dinggefei/fridge-eink-display/docs/README.md

# 文档索引

当前实施基线为 V1.1：

- [正式用户使用说明书（Markdown）](USER_GUIDE.md)
- [PRD V1.1（Markdown）](PRD_V1.1.md)
- [GDEM075F53 480×800 竖屏预览](assets/screen_preview_f53_portrait.png)
- [GDEM075F53 800×480 原生传输图](assets/screen_preview_f53.png)
- [黄历模式 480×800 真实日期预览](assets/almanac_preview_f53_portrait.png)
- [黄历模式 800×480 原生传输图](assets/almanac_preview_f53.png)
- [黄历天气模式 480×800 布局预览](assets/almanac_weather_preview_f53_portrait.png)
- [黄历天气模式 800×480 原生传输图](assets/almanac_weather_preview_f53.png)
- [当前库存动态四色屏预览](assets/current_inventory_preview.png)

历史版本：

- [PRD V1.0（Markdown）](PRD_V1.0.md)

V1.1 已按实物硬件锁定 ESP32-S3 N16R8、GDEM075F53、JD79665CA 和
DESPI-C02。首次真机点屏仍须以 Good Display 的 F53 官方 ESP32 示例确认
初始化序列、像素顺序和四色编码，确认后再固化设备帧协议。
