dinggefei/fridge-eink-display/backend/THIRD_PARTY_NOTICES.md

# Third-party notices

## lunar-python 1.4.8

Project: https://github.com/6tail/lunar-python

MIT License

Copyright (c) 2020 6tail

Permission is hereby granted, free of charge, to any person obtaining a copy
of this software and associated documentation files (the "Software"), to deal
in the Software without restriction, including without limitation the rights
to use, copy, modify, merge, publish, distribute, sublicense, and/or sell
copies of the Software, and to permit persons to whom the Software is
furnished to do so, subject to the following conditions:

The above copyright notice and this permission notice shall be included in all
copies or substantial portions of the Software.

THE SOFTWARE IS PROVIDED "AS IS", WITHOUT WARRANTY OF ANY KIND, EXPRESS OR
IMPLIED, INCLUDING BUT NOT LIMITED TO THE WARRANTIES OF MERCHANTABILITY,
FITNESS FOR A PARTICULAR PURPOSE AND NONINFRINGEMENT. IN NO EVENT SHALL THE
AUTHORS OR COPYRIGHT HOLDERS BE LIABLE FOR ANY CLAIM, DAMAGES OR OTHER
LIABILITY, WHETHER IN AN ACTION OF CONTRACT, TORT OR OTHERWISE, ARISING FROM,
OUT OF OR IN CONNECTION WITH THE SOFTWARE OR THE USE OR OTHER DEALINGS IN THE
SOFTWARE.

## Market data services

Cryptocurrency quotes may be supplied by CoinGecko. Display attribution:
"Data provided by CoinGecko". API documentation and current terms:

- https://docs.coingecko.com/reference/simple-price
- https://www.coingecko.com/en/terms

Stock and index quotes may be supplied by Twelve Data. API documentation and
current terms:

- https://twelvedata.com/docs/introduction/overview
- https://twelvedata.com/terms

Stock and index quotes may also be supplied by the Longbridge OpenAPI Python
SDK, which is dual-licensed under Apache-2.0 and MIT. API documentation,
source code and current terms:

- https://open.longbridge.com/zh-CN/docs/quote/overview
- https://github.com/longbridge/openapi
- https://longbridge.com/terms

API access does not by itself grant every redistribution or public-display
right. The production operator must keep an appropriate plan and verify the
terms for each exchange and use case before enabling the market dashboard.

## Weather data service

Weather location and daily forecast data may be supplied by QWeather. The Mini
Program displays “天气服务由和风天气驱动” and the service website:

- https://www.qweather.com
- https://dev.qweather.com/docs/terms/attribution/

The e-ink screen intentionally omits a source footer. Before distributing the
physical device, the production operator must confirm that the selected plan
and any special-device attribution permission cover this presentation.
