dinggefei/fridge-eink-display/hardware/enclosure_v0_1/README.md

# 冰箱食物管理水墨屏外壳 V0.1

这是一套竖屏、磁吸冰箱门安装的原型外壳，适配当前已确认的 7.5 英寸水墨屏、ESP32-S3、DESPI-C02、806090 聚合物电池和 Seeed Studio Lipo Rider Plus。

V0.1 的目标是验证尺寸、装配、接口位置和磁吸强度，不是可直接销售的量产结构。当前成品外轮廓约为 **128 × 200 × 28.2 mm**。宽度从早期估算的 124 mm 增加到 128 mm，是为了在 112 mm 屏幕玻璃仓两侧保留可靠的螺丝柱和壳体强度。

## 必须先做的事情

不要直接打印完整外壳。先打印 `output/` 目录中的三个试配件：

1. `fit_test_screen_width_112mm.stl`：检查屏幕玻璃能否自然放入 112 mm 间距，不能夹紧或强塞。
2. `fit_test_battery_thickness_9mm.stl`：检查带保护板电池的实际厚度。槽高 9 mm；电池不得被挤压。
3. `fit_test_m2_insert_and_magnet.stl`：检查 M2 热熔螺母、M2 通孔和 10 × 3 mm 磁铁的实际公差。

只有三个试配件都通过，才打印三件主外壳。若任一试配件过紧或过松，先修改 `generate_enclosure.py` 参数并重新导出。

## 主打印文件

- `front_bezel_v0_1.stl`：正面边框、屏幕窗口和屏幕定位框。
- `middle_carrier_v0_1.stl`：屏幕背板以及电池、ESP32-S3、DESPI-C02、Lipo Rider Plus 的扎带固定孔。
- `rear_cover_v0_1.stl`：后盖、底部充电口和开关口、磁铁仓及后盖螺丝孔。

实物试摆已确认 V0.1 中层托板和后盖接口位置不正确。V0.1 现在只继续使用
`front_bezel_v0_1.stl`；中层托板和后盖改用
[`../enclosure_v0_3/README.md`](../enclosure_v0_3/README.md) 中的 V0.3 文件。

所有 STL 的单位均为 **毫米**，严禁自动缩放。

## 设计依据与待实物确认项

当前模型使用以下尺寸：

| 部件 | 模型采用尺寸 | 说明 |
| --- | --- | --- |
| GDEM075F53 | 111.2 × 170.2 × 1.2 mm | 屏幕仓 112 × 171 mm |
| ESP32-S3 开发板 | 27 × 65 mm 安装包络 | 用户实测板体约 25 × 63 × 8 mm，额外留装配余量 |
| DESPI-C02 | 42 × 24 mm 安装包络 | 裸板约 40 × 22 × 2 mm |
| 806090 电池 | 63 × 95 × 最大 10 mm 安装包络 | 下单电芯标称约 60 × 90 × 8 mm，必须以到货实测为准 |
| Lipo Rider Plus | 27 × 43 mm 安装包络 | 兼容约 25 × 41 mm 板体 |

以下尺寸目前仍需要装机验证：

- 电池保护板、导线出口和泡棉后的最大厚度。
- DESPI-C02 插入排线和杜邦线后的最大高度。
- Lipo Rider Plus 的 Type-C 插头和 USB-A 线缆弯折空间。
- 实物水墨屏的排线出口方向、窗口居中位置和玻璃批次公差。
- 冰箱门表面的磁吸效果；玻璃门或非磁性门不能依赖磁铁固定。

## 打印参数

建议第一版使用白色或浅灰色 PETG：

- 工艺：FDM。
- 喷嘴：0.4 mm。
- 层高：0.20 mm。
- 壁厚：4 道墙。
- 顶层/底层：各 5 层。
- 填充：20%～25% Gyroid。
- 尺寸补偿：关闭自动缩放；先用试配件验证商家的机器公差。

摆放方向：

- 正面边框：外观正面朝下打印；使用干净、平整的打印板。
- 中层托板：平整的屏幕接触面朝下打印。
- 后盖：贴冰箱的一面朝下打印。
- 支撑：默认不加全局支撑；若切片软件提示底部接口桥接风险，仅对接口位置增加局部支撑。

## 五金与辅料

- 10 × 3 mm 圆形强磁铁：6 个。建议购买 8 个，保留备件。
- M2 热熔铜螺母，外径约 3.2 mm、长度 4 mm：10 个。
- M2 × 6 mm 螺丝：6 个，用于中层托板固定到正面边框。
- M2 × 18 mm 螺丝：4 个，用于后盖；实际长度以试装为准，可同时准备 M2 × 16 和 M2 × 20。
- 0.5 mm EVA 泡棉胶：贴屏幕四周，不得覆盖显示区域或排线。
- 细魔术贴扎带或 2.5 mm 尼龙扎带：固定电池和各电路板。
- 薄毛毡或 TPU 防滑垫：贴后盖四角，防止刮伤冰箱门。
- 中性硅胶或适用于 PETG 的结构胶：磁铁试装确认后再粘接。

## 装配顺序

1. 仅拿空外壳安装热熔螺母。电池、屏幕和电路板必须远离烙铁，等待外壳完全冷却。
2. 将 0.5 mm EVA 贴在屏幕定位框四周，不能压住玻璃边缘和排线。
3. 屏幕自然放入正面边框，不得掰弯、挤压或用螺丝直接压玻璃。
4. 放上中层托板，用 6 颗 M2 × 6 mm 螺丝均匀、轻力锁紧。
5. 使用扎带固定电池和电路板；ESP32-S3 天线区域保持无遮挡，顶部区域不放磁铁和电池。
6. 检查 Type-C、开关、USB 线和排线均无受力，再通电做桌面测试。
7. 确认磁铁孔尺寸和极性后粘磁铁。所有磁铁朝冰箱的一面极性保持一致。
8. V0.3 托板必须搭配 V0.3 后盖，四颗后盖螺丝均可使用；如有翘曲立即停止并
   检查线缆和电池位置。

锂电池不得被螺丝、毛刺、扎带或壳体挤压。发现电池鼓包、破损、异常发热或异味时立即断电并停止使用。

## 重新生成与校验

在本目录运行：

```bash
python3 -m venv .venv-cad
source .venv-cad/bin/activate
python -m pip install -r requirements-cad.txt
python generate_enclosure.py
```

生成器会重新输出 STL、GLB、PNG 和 `output/manifest.json`。如果任一模型不是封闭实体或不是有效体积，脚本会直接报错而不会静默交付。
