dinggefei/fridge-eink-display/hardware/enclosure_v0_2/README.md

# 冰箱食材清单外壳：V0.2 中层托板

本目录只替换 **中层托板**。已经打印完成的以下 V0.1 零件继续使用，不需要重打：

- `front_bezel_v0_1.stl`
- `rear_cover_v0_1.stl`

## 为什么需要 V0.2

V0.1 的电子元件布局存在两个实际装配问题：

1. DESPI-C02 没有固定在屏幕 FPC 出口旁，FPC 无法自然直插。
2. Lipo Rider Plus 被按“USB-C 居中”处理，但官方 PCB 文件显示 USB-C 横向偏离板中心约 5.46 mm，导致原充电口难以对准。

V0.2 将元件改为：

- 左侧中部：806090 电池，竖放，两条魔术贴固定。
- 右上：ESP32-S3，竖放，天线朝上、USB-C 朝下。
- 右侧中部：DESPI-C02，横放，FPC 接口朝右并正对原 FPC 开槽。
- 左下：Lipo Rider Plus，按官方 4 个安装孔定位，USB-C 对准原后盖充电口。

## 与原后盖的兼容方式

原后盖保持不变。Lipo Rider Plus 的真实 PCB 位置与左下后盖螺柱冲突，因此：

- 右下、左上、右上共 3 颗后盖螺钉继续使用。
- 左下后盖螺钉不安装；托板上不再设置对应的热熔铜螺母柱。
- 原后盖左下螺钉孔可以装一颗不超过 5 mm 的短装饰螺钉，或者暂时空置；不要使用原来的长螺钉硬拧。

3 颗 M2 螺钉配合原后盖内部承托边，足以固定原型机后盖。

## 打印文件

- `output/middle_carrier_v0_2.stl`
- 打印店压缩包：`RFM_middle_carrier_v0_2_STL.zip`
- 布局图：`previews/middle_carrier_v0_2_layout.png`
- 三维预览：`previews/middle_carrier_v0_2.png`

## 建议打印参数

- 材料：PETG
- 喷嘴：0.4 mm
- 层高：0.20 mm
- 壁数：4
- 顶层/底层：5
- 填充：25%
- 支撑：关闭
- 摆放：大平面贴打印平台
- 数量：1 件

## 安装顺序

1. 先把屏幕和 DESPI-C02 接好，确认 FPC 完全插入并锁紧 ZIF 卡扣。
2. 用一条 6～8 mm 宽魔术贴将 DESPI-C02 固定在右侧中部，FPC 不得折死。
3. 用四颗 M2 × 4 mm 自攻螺钉固定 Lipo Rider Plus；USB-C 必须朝向托板底边。
4. 用两条 10～12 mm 宽魔术贴固定电池，电池与托板之间垫 0.5 mm EVA。
5. 固定 ESP32-S3；天线区域不要覆盖泡棉、导线或电池。
6. 接好短 SPI 线和短 USB-A 转 Type-C 供电线，再合上原后盖。
7. 后盖只安装 3 颗长 M2 螺钉：右下、左上、右上。左下长螺钉不要安装。

## 合盖前检查

- DESPI-C02 的 FPC 是直插状态，无明显拉力。
- Lipo Rider Plus 的 USB-C 能从原后盖充电孔正常插拔。
- 电池没有被托板、螺柱或后盖挤压。
- 所有板底焊点均有绝缘垫，导线不会碰到屏幕金属背板。
- 合盖后轻晃无明显异响，再进行通电测试。

> 原后盖底部原本预留的“开关孔”不能直接触达 Lipo Rider Plus 板载开关。V0.2 原型先将板载开关保持在 ON；该孔暂作预留，不在本次中层托板改版中扩展外置开关功能。
