dinggefei/fridge-eink-display/hardware/enclosure_v0_5/README.md

# 冰箱食材清单外壳 V0.5：装配公差与 ESP32 四孔固定版

> 2026-08-21 更新：ESP32-S3 不再使用扎带固定。中层托板改为利用开发板
> 四角的 4 个原生安装孔，以 4 颗 `M2×4 mm` 自攻螺丝固定。
>
> 2026-08-22 位置更新：ESP32 整板和四个安装孔向顶部充电口方向移动
> `25 mm`，后盖 BOOT/RESET 两个操作孔同步移动 `25 mm`。Lipo Rider 和
> 顶部充电口保持不动。
>
> 2026-08-22 后盖方向修正：后盖从外侧底视图观察时，BOOT/RESET 应位于
> 左侧。后盖孔位已沿 X 方向镜像，并在外表面增加 `BOOT`、`RESET` 两组
> `0.55 mm` 深凹刻标识。STL 和 1:1 SVG 均不需要再手工镜像。
>
> 2026-08-22 磁力增强：后盖磁铁由 6 颗增加为 10 颗，继续使用
> `Ø10×3 mm` 圆形磁铁。磁铁改为非对称安全布局，避开 ESP32 PCB
> 天线、ESP32 板体、DESPI-C02 与 Lipo Rider Plus。
>
> 2026-08-22 底边开孔更新：后盖底边原有的两个 `12×2 mm` 横向泄压孔
> 已取消并封闭为实心壁。顶部 USB-C 充电口保留。

> 2026-08-16 修正：最初生成的两个角部检具错误地截取了托板右上角和后盖右上角。
> 后盖合上时会左右镜像，正确组合应为“托板右上角 + 后盖左上角”。当前下载包
> 已修正；此前打印的同侧角检具作废。完整托板和完整后盖尺寸没有改变。

复核发现 V0.4 的中层托板为 `123 × 195 mm`，后盖内腔为
`123.8 × 195.8 mm`，每边只有 `0.4 mm` 间隙。对于接近 20 cm 的 FDM
打印件，该间隙容易被材料收缩、首层象脚和边缘毛刺吃掉，因此可能很难装入。

V0.5 调整为：

| 项目 | V0.4 | V0.5 |
|---|---:|---:|
| 中层托板 | 123 × 195 mm | 123 × 195 mm，保持不变 |
| 后盖内腔 | 123.8 × 195.8 mm | 124.6 × 196.6 mm |
| 每边装配间隙 | 0.4 mm | 0.8 mm |
| 后盖最小侧壁 | 2.1 mm | 1.7 mm |
| 托板与承托台阶搭接 | 1.6 mm | 1.2 mm |
| 后盖外轮廓 | 128 × 200 mm | 128 × 200 mm，保持不变 |

`1.7 mm` 侧壁适合 0.4 mm 喷嘴打印约 4 道墙；`1.2 mm` 台阶搭接仍能承托
托板。顶部充电口和 Lipo Rider 位置不变；ESP32 及对应的 BOOT/RESET 后盖孔
按上述要求同步上移 `25 mm`。

## ESP32 四孔固定参数

开发板外形参考[微雪 ESP32-S3-DEV-KIT-NXRX 官方尺寸图](https://docs.waveshare.com/ESP32-S3-DEV-KIT-N8R8)，
四孔孔距采用用户在 `2026-08-22` 对实际 `ESP32-S3-DEV-KIT-N16R8` 板卡的测量值：

| 项目 | 数值 |
|---|---:|
| 开发板外形 | 63.30 × 25.40 mm |
| 原生安装孔 | 4 × Ø2.00 mm |
| 左右孔距 | 22.00 mm，实测 |
| 上下孔距 | 60.00 mm，实测 |
| 中托螺丝柱外径 | 5.80 mm |
| 自攻底孔 | Ø1.70 × 2.50 mm 深，盲孔 |
| 固定螺钉 | 4 × M2×4 mm 自攻螺丝 |
| PCB 标称厚度 | 1.60 mm |
| 标称啮合长度 | 2.40 mm |

使用要求：

1. 四角 4 个原生孔必须全部固定，不能只装两颗螺丝。
2. 螺钉头外径应不大于 `3.6 mm`；下方靠近 USB-C 的两颗螺钉禁止加垫圈，
   避免遮挡 BOOT/RESET 按钮。
3. 仅拧到开发板不晃动即可，不要继续强拧到底，以免中托螺丝柱开裂。
4. 不要把 `M2×6 mm` 直接替代 `M2×4 mm`，因为盲孔深度按 M2×4 设计。
5. 从后盖操作 BOOT/RESET 时使用直径不大于 `1.5 mm` 的非金属细杆。
6. `esp32_four_hole_alignment_v0_5.png` 展示四颗螺丝与 BOOT/RESET 后盖孔的
   同时对位关系；`placement_template_v0_5_1to1.svg` 可按 100% 打印复核孔位。

更新后的载板坐标以中托中心为 `(0, 0)`：

- ESP32 中心：`(-35.00, 45.00)`。
- 下方两个安装孔：`(-46.00, 15.00)`、`(-24.00, 15.00)`。
- 上方两个安装孔：`(-46.00, 75.00)`、`(-24.00, 75.00)`。
- 开发板元件面 BOOT 中心：`(-43.146, 15.905)`。
- 开发板元件面 RESET 中心：`(-27.758, 15.678)`。
- 后盖模型 BOOT 孔中心：`(43.146, 15.905)`；从后盖外侧底视图看位于左侧。
- 后盖模型 RESET 孔中心：`(27.758, 15.678)`；从后盖外侧底视图看位于左侧。

后盖安装时会左右翻转，因此开发板按钮和后盖模型孔的 X 坐标符号相反，这是
正确的装配关系。不要在切片软件中再次镜像后盖。

后盖底边不再保留泄压孔或走线孔；底边应是完整连续的实心外壁。

## 后盖磁铁参数

| 项目 | 数值 |
|---|---:|
| 磁铁数量 | 10 颗 |
| 磁铁规格 | Ø10×3 mm |
| 盲孔尺寸 | Ø10.4×3.2 mm |
| 冰箱门一侧保留PETG厚度 | 0.8 mm |
| 装配后投影坐标 | 见下方列表 |

磁铁中心坐标以中托上的电子器件视图为准，顶部 USB-C 方向为
`Y+`：

```text
(-52, -70)   (0, -70)   (52, -70)
(-52, -40)   (0, -40)   (52, -40)
(-52, -10)
(0, 30)
(52, 35)     (52, 70)
```

后盖合上时会左右翻转，因此 STL 内部盲孔的 X 坐标与上述装配投影
坐标符号相反。这个镜像已经由生成程序处理，不要在切片软件中再次镜像。

保守的平面投影净距为：ESP32 PCB 天线 `33.52 mm`、ESP32 板体
`17.10 mm`、DESPI-C02 `17.16 mm`、Lipo Rider Plus `20.05 mm`。
`magnet_electronics_clearance_v0_5.png` 展示装配后的磁铁与电子器件相对位置。

磁铁从后盖内侧装入盲孔。先逐孔试放，确认能自然放入且不晃动，再使用少量适合
PETG的结构胶固定。胶水固化前不得合盖；不得敲击、强压磁铁，也不要通过减薄
外侧 `0.8 mm` 表皮来增加吸力。

## 必须先打印 ESP32 四孔检具

在打印完整中层托板前，先打印：

`fit_test_esp32_four_hole_mount_v0_5.stl`

检具验收顺序：

1. 检具底边缺口朝向开发板 USB-C 端。
2. 将真实 ESP32 的 4 个原生孔自然落到 4 个螺丝柱中心；不得弯板或斜压。
3. 先徒手放入 4 颗 M2×4，自然旋入 1～2 圈，确认四孔可同时对中。
4. 按对角顺序逐步拧紧，开发板应平放，四角不能翘起。
5. 用细塑料杆分别按压 BOOT 和 RESET，螺钉头不得妨碍按键。
6. 四孔全部对齐、板面平整、可正常按键，才允许打印完整
   `middle_carrier_v0_5.stl`。

任何一个孔需要扩孔、掰板或强行拉到螺丝柱上，都判定为失败；不要继续打印完整件。

## 当前安装位置图

器件位置以 `enclosure_v0_5_four_hole_layout.png` 为准：

1. Lipo Rider Plus 位于顶部中央，USB-C 充电口朝向后盖顶部开孔。
2. ESP32-S3 位于左侧，天线朝上，BOOT、RESET 和 Type-C 朝下；四角使用
   M2×4 自攻螺丝固定，不使用扎带。
3. DESPI-C02 位于右侧中部，白色 FPC 插座朝右并直连屏幕排线。
4. 806090 电池横放在下半部电池槽内。

当前精确图分为：

- `enclosure_v0_5_four_hole_layout.png`：上移 25 mm 后的完整器件位置。
- `esp32_four_hole_alignment_v0_5.png`：四颗螺丝、BOOT/RESET 和后盖孔的相对位置。
- `carrier_rear_clearance_v0_5.png`：中托与后盖的装配间隙。
- `rear_cover_bottom_view_v0_5.png`：从后盖外表面观察的最终孔位和文字方向。

此前的写实效果图仍是 ESP32 上移前的位置，已从正式打印包中移除。打印尺寸以
STL、`manifest.json` 和 1:1 SVG 模板为准。实际供电顺序为“电池 → Lipo Rider
电池接口 → Lipo Rider USB-A 输出 → ESP32-S3 USB-C”。

## 必须先打印角部试配件

不要先打印完整托板和后盖。先打印以下两个小件：

1. `fit_test_carrier_corner_v0_5.stl`
2. `fit_test_rear_corner_v0_5.stl`

两个试配件必须使用与正式件相同的材料、打印机、喷嘴、层高和缩放设置。

验收方法：

1. 去掉裙边、拉丝和明显毛刺，但不要打磨配合边。
2. 将托板角部试件按螺丝柱方向放入后盖角部试件。
3. 后盖角件空腔朝上；托板角件左右翻面、元件柱朝下后再合入。
4. 圆角与螺丝孔应同时重合；应能用手自然放入和取出，不需要掰后盖，
   也不能靠螺钉拉进去。
5. 轻晃时允许很小的活动量，但不能明显横向晃动或脱出台阶。
6. 试件通过后，才打印 `middle_carrier_v0_5.stl` 和 `rear_cover_v0_5.stl`。

这里的角部试件只验证“中托能否装入后盖”；ESP32 四孔检具另行验证真实开发板
孔距。两类检具都通过后，才打印完整中托。

如果试件仍紧，先确认切片软件没有自动缩放、首层没有明显象脚，再调整模型；
不要直接打印完整件碰运气。

## 打印设置

- PETG，0.4 mm 喷嘴，0.20 mm 层高。
- 4 道墙，顶层/底层各 5 层，25% Gyroid。
- STL 单位为毫米，自动缩放关闭。
- 建议开启切片软件的象脚补偿 `0.15～0.20 mm`；不同软件名称可能是
  `Elephant Foot Compensation` 或“首层水平扩展补偿”。

## 重新生成

```bash
../enclosure_v0_1/.venv-cad/bin/python generate_enclosure_v0_5.py
```

所有 STL 导出后都会重新加载，验证水密、有效体积和单一实体。
