dinggefei/fridge-eink-display/docs/assets/almanac_weather_preview_f53.png

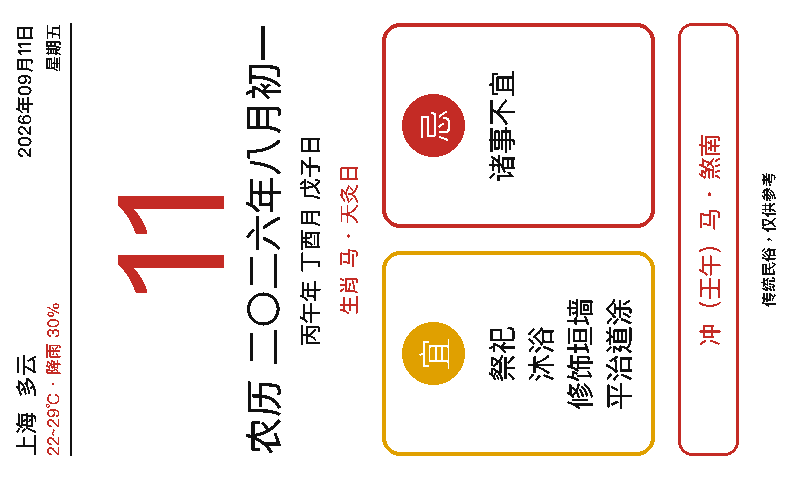
docs/assets/almanac_weather_preview_f53.png
