dinggefei/fridge-eink-display/docs/assets/market_preview_f53.png

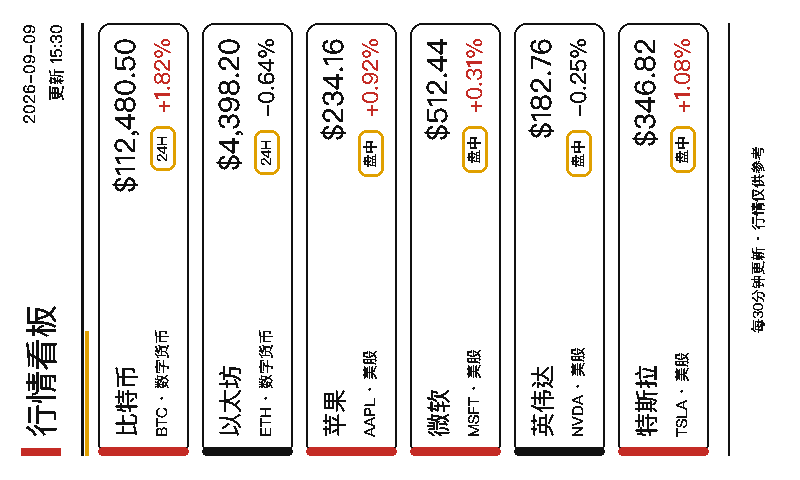
docs/assets/market_preview_f53.png
