dinggefei/fridge-eink-display/docs/assets/screen_preview_f53.png

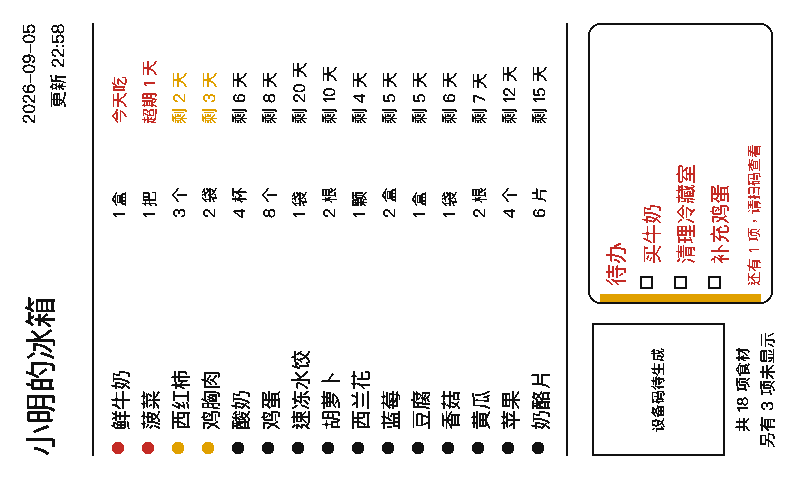
docs/assets/screen_preview_f53.png
