dinggefei/fridge-eink-display/docs/assets/timetable_mode/three_day_timetable_20260917_portrait.png

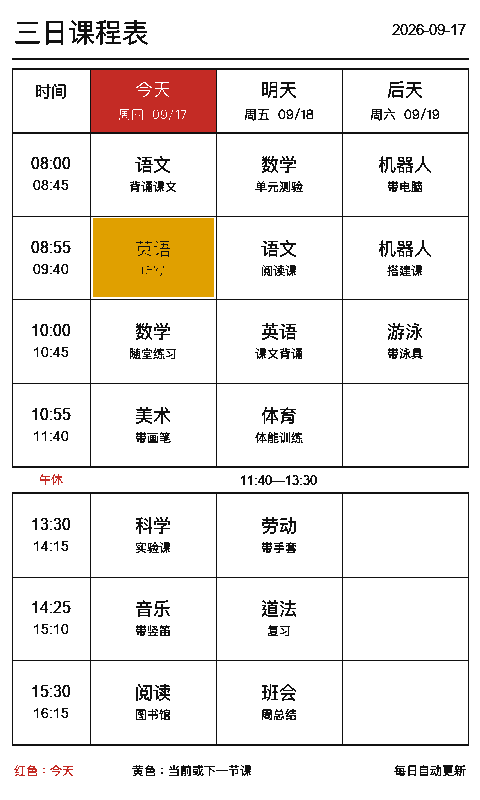
docs/assets/timetable_mode/three_day_timetable_20260917_portrait.png
