dinggefei/fridge-eink-display/docs/assets/timetable_mode/three_day_timetable_implemented_20260917_native.png

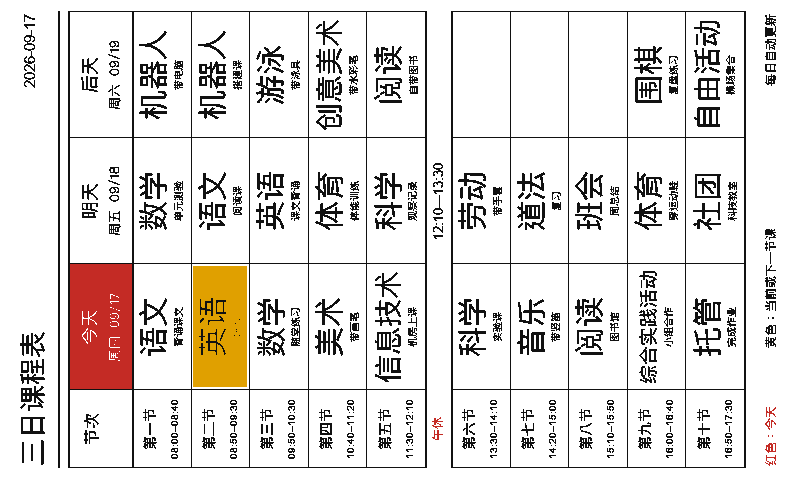
docs/assets/timetable_mode/three_day_timetable_implemented_20260917_native.png
