dinggefei/fridge-eink-display/docs/assets/timetable_mode/weekly_timetable_20260916_native.png

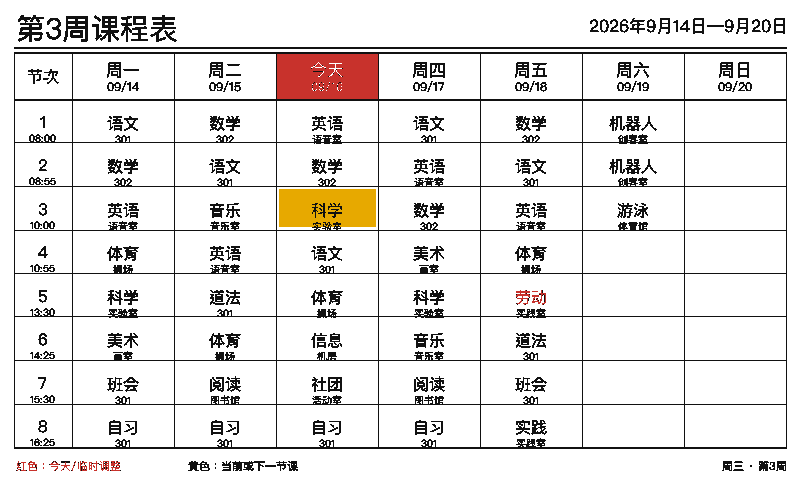
docs/assets/timetable_mode/weekly_timetable_20260916_native.png
