dinggefei/fridge-eink-display/docs/assets/timetable_mode/weekly_timetable_adaptive_font_20260919_preview.png

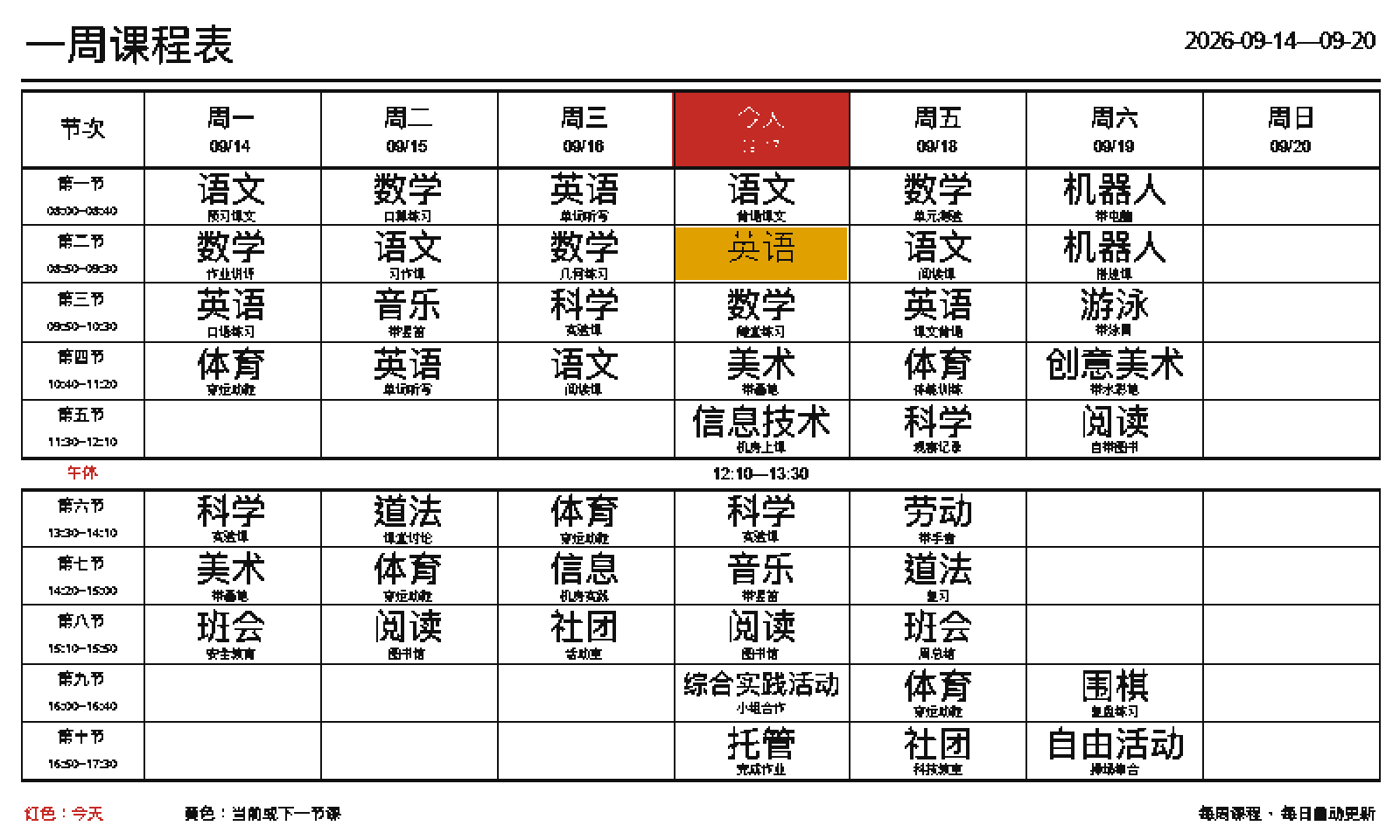
docs/assets/timetable_mode/weekly_timetable_adaptive_font_20260919_preview.png
