dinggefei/fridge-eink-display/docs/assets/timetable_mode/weekly_timetable_custom_periods_20260916_native.png

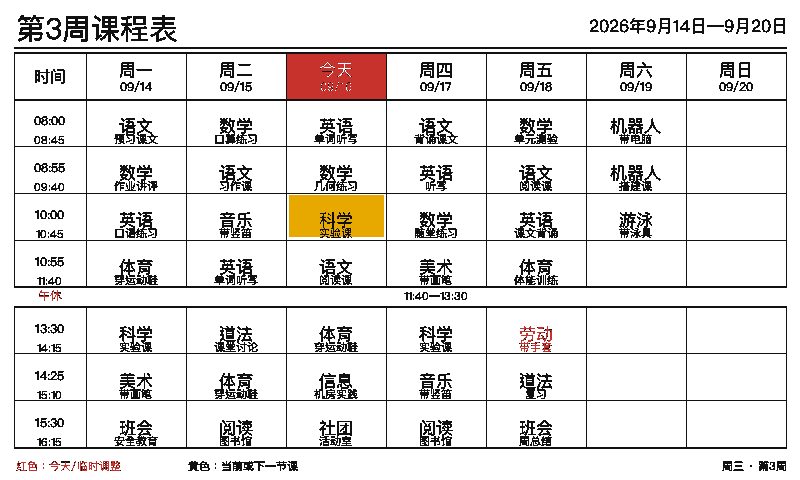
docs/assets/timetable_mode/weekly_timetable_custom_periods_20260916_native.png
