dinggefei/fridge-eink-display/docs/assets/timetable_mode/weekly_timetable_custom_periods_20260916_preview.png

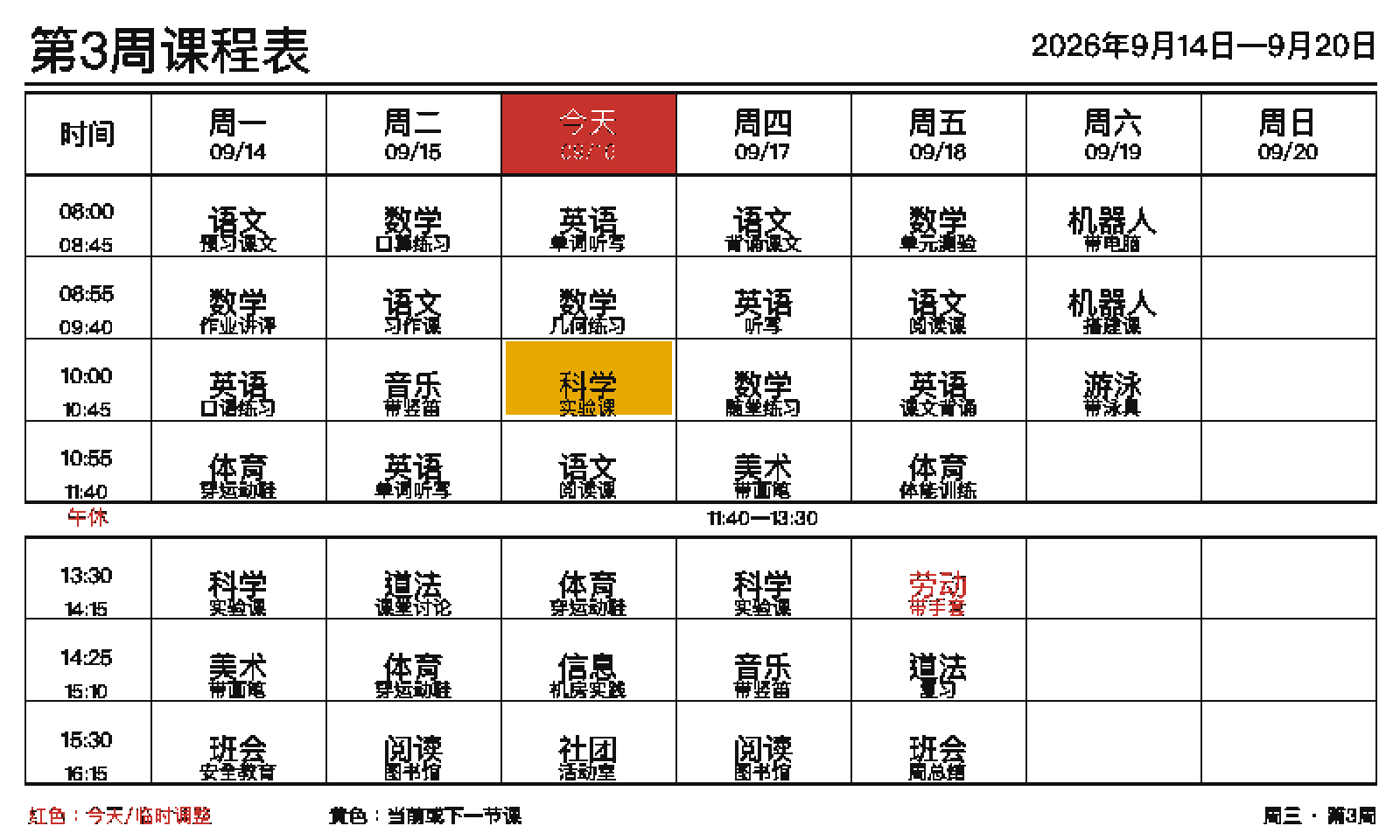
docs/assets/timetable_mode/weekly_timetable_custom_periods_20260916_preview.png
