dinggefei/fridge-eink-display/docs/assets/timetable_mode/weekly_timetable_implemented_20260916_preview.png

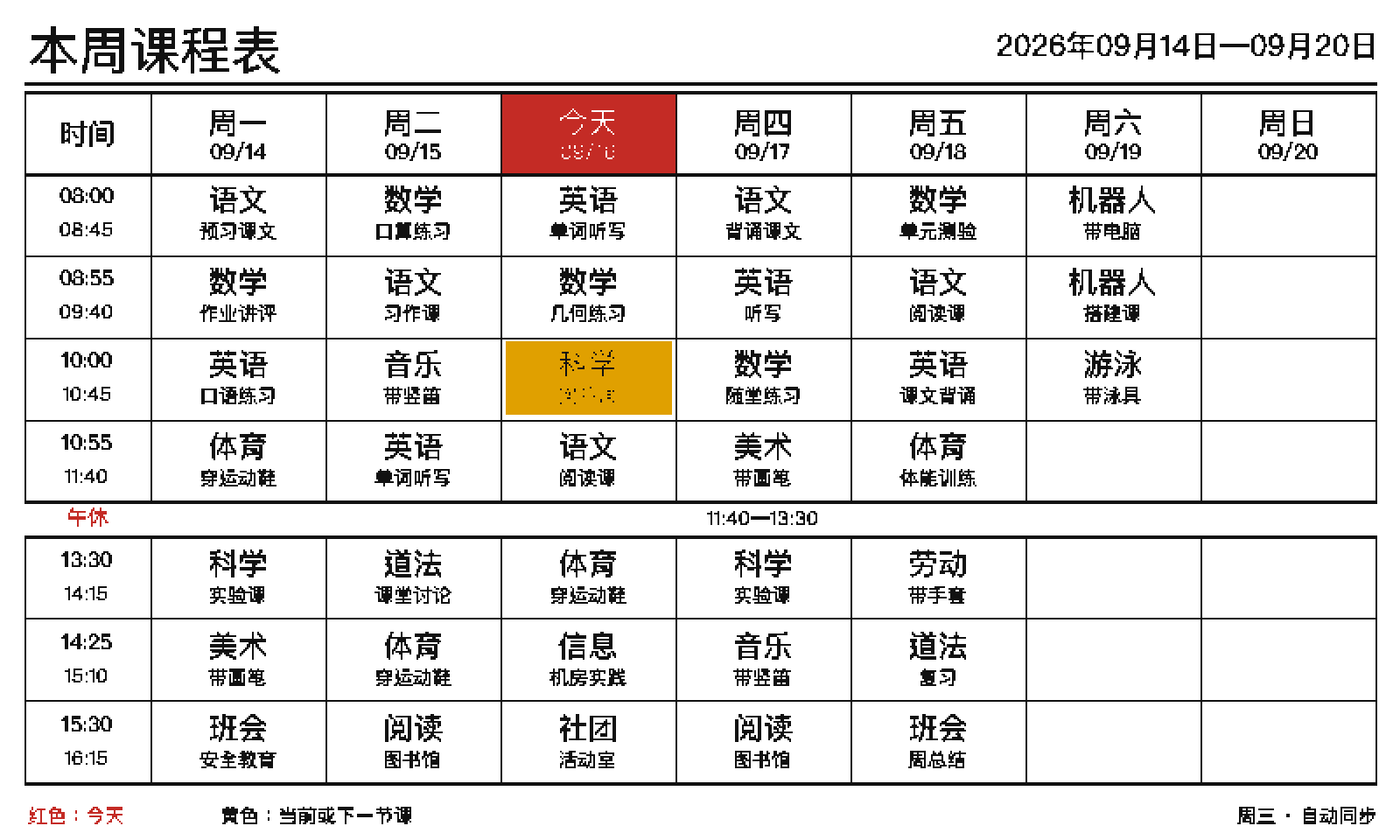
docs/assets/timetable_mode/weekly_timetable_implemented_20260916_preview.png
