dinggefei/fridge-eink-display/docs/assets/weather_mode/weather_7day_20260915_native.png

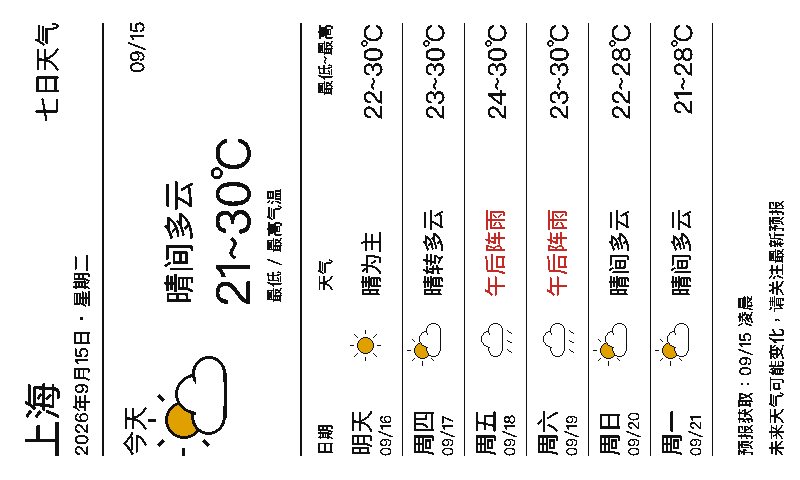
docs/assets/weather_mode/weather_7day_20260915_native.png
