dinggefei/fridge-eink-display/hardware/enclosure_v0_7/previews/compact_enclosure_overview_v0_7.png

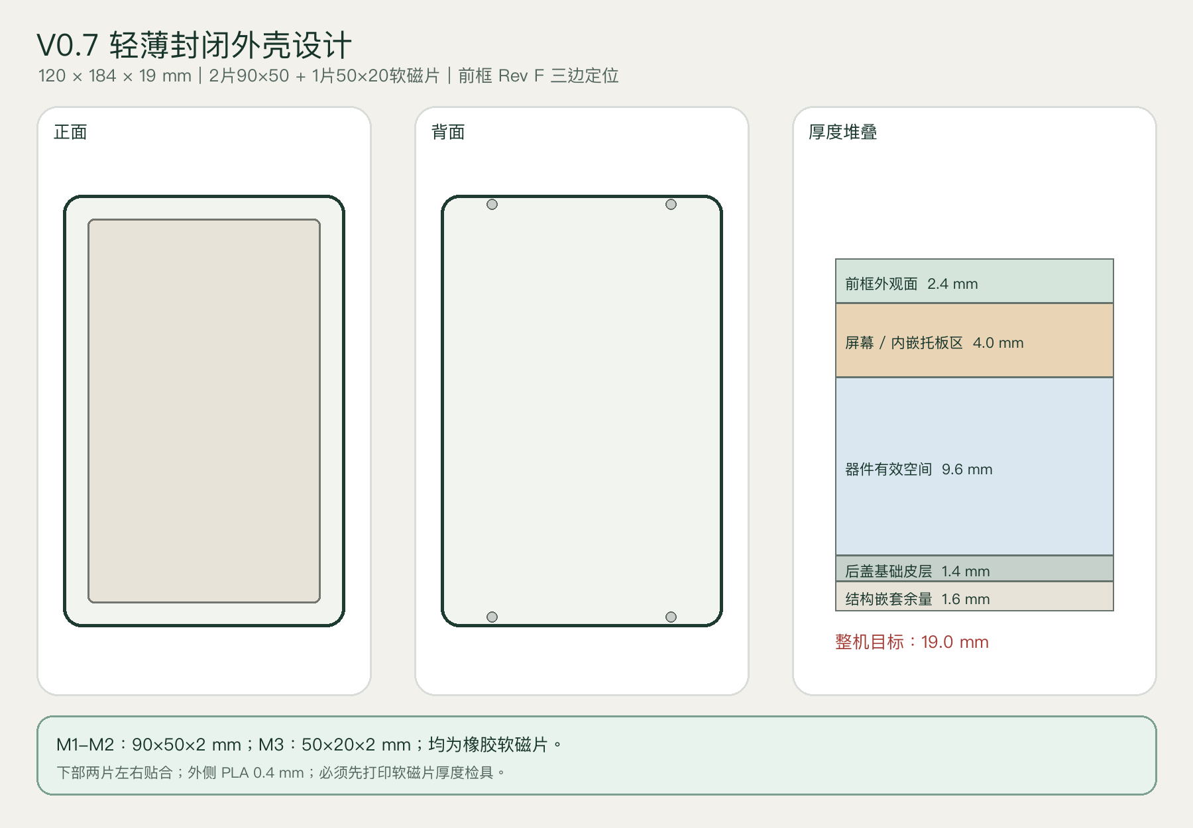
hardware/enclosure_v0_7/previews/compact_enclosure_overview_v0_7.png
