dinggefei/fridge-eink-display/hardware/enclosure_v0_7/previews/esp32_dupont_terminal_clamp_v0_7_rev_a.png

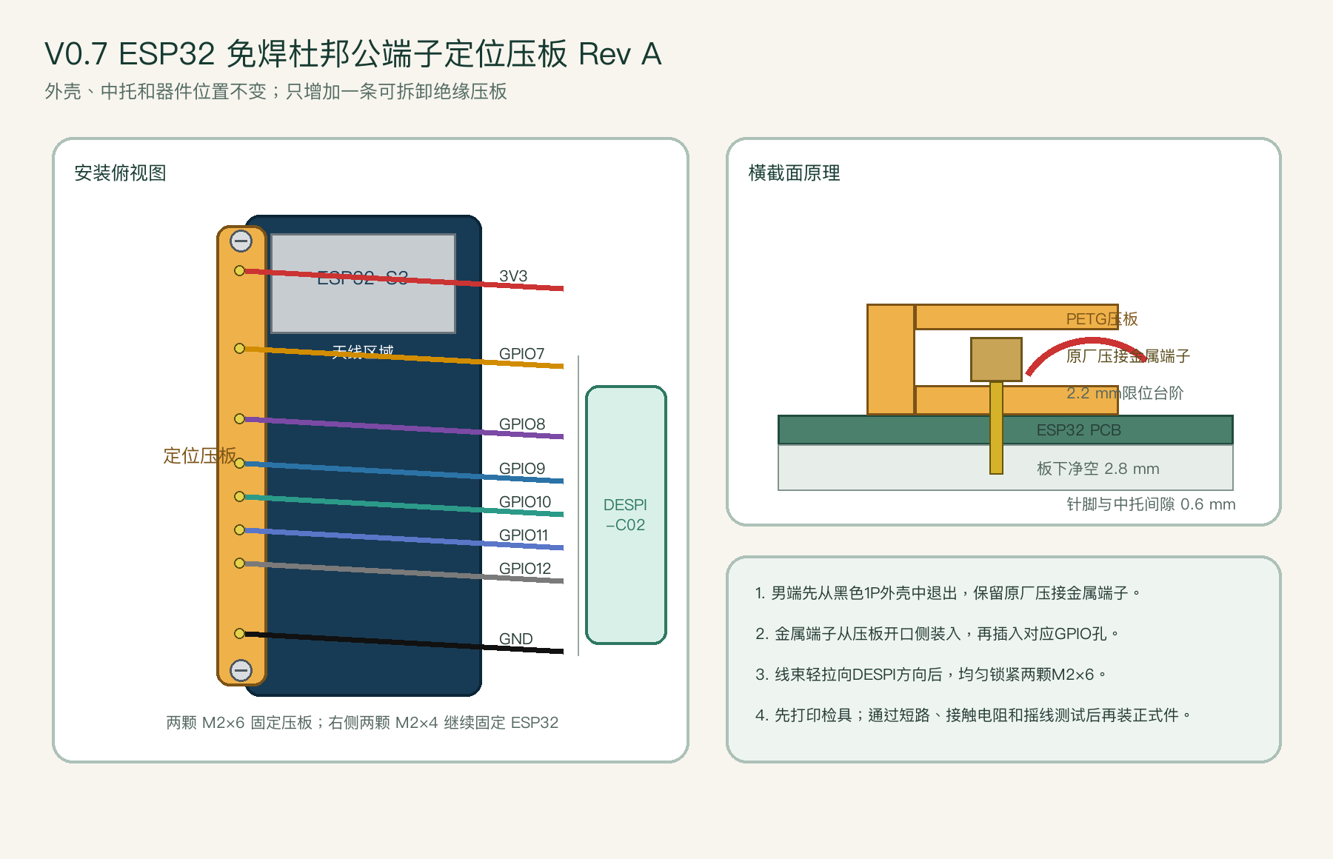
hardware/enclosure_v0_7/previews/esp32_dupont_terminal_clamp_v0_7_rev_a.png
