dinggefei/fridge-eink-display/hardware/enclosure_v0_7/previews/front_retainer_revision_v0_7_rev_f.png

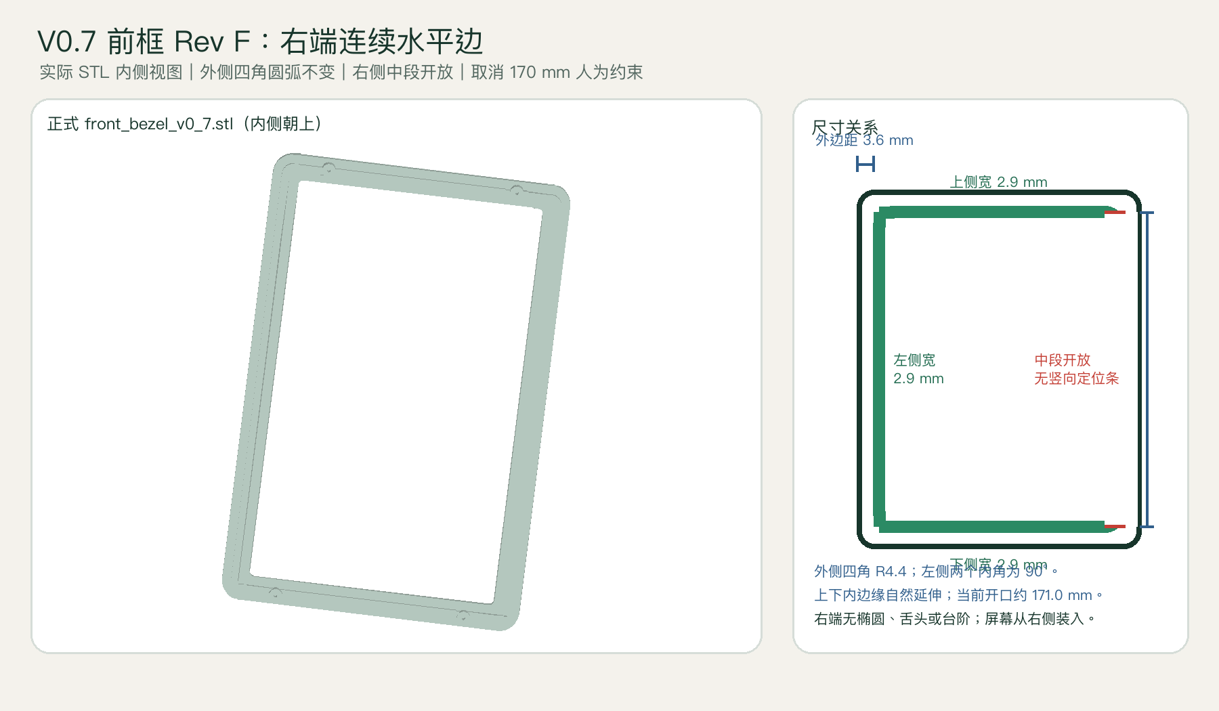
hardware/enclosure_v0_7/previews/front_retainer_revision_v0_7_rev_f.png
