dinggefei/fridge-eink-display/hardware/enclosure_v0_7/previews/lipo_regular_opening_proposal_v0_7.png

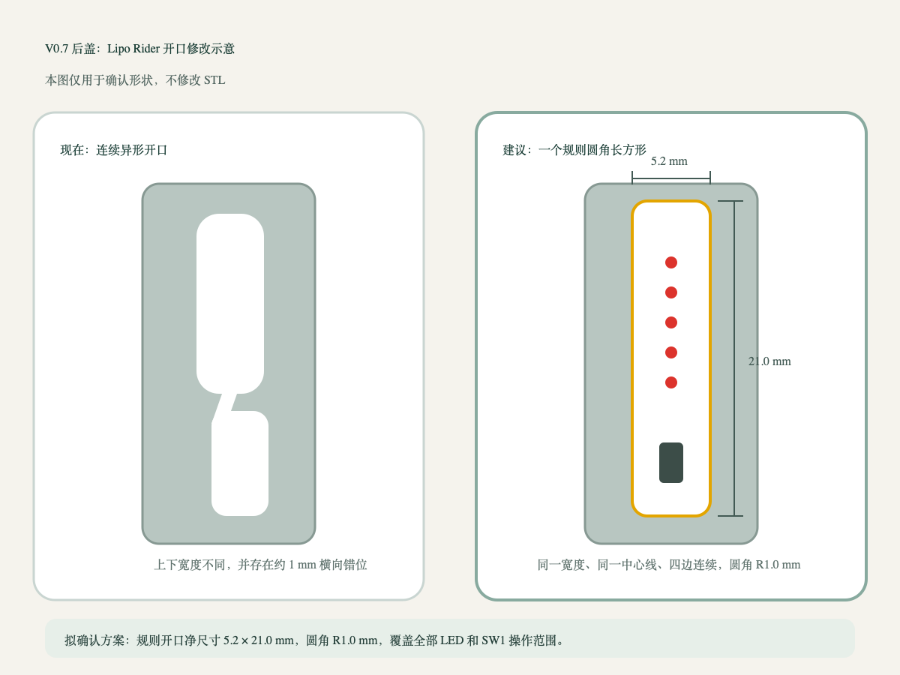
hardware/enclosure_v0_7/previews/lipo_regular_opening_proposal_v0_7.png
