dinggefei/fridge-eink-display/hardware/enclosure_v0_7/previews/magnet_layout_1x90x50_2x50x20_proposal_v0_7.png

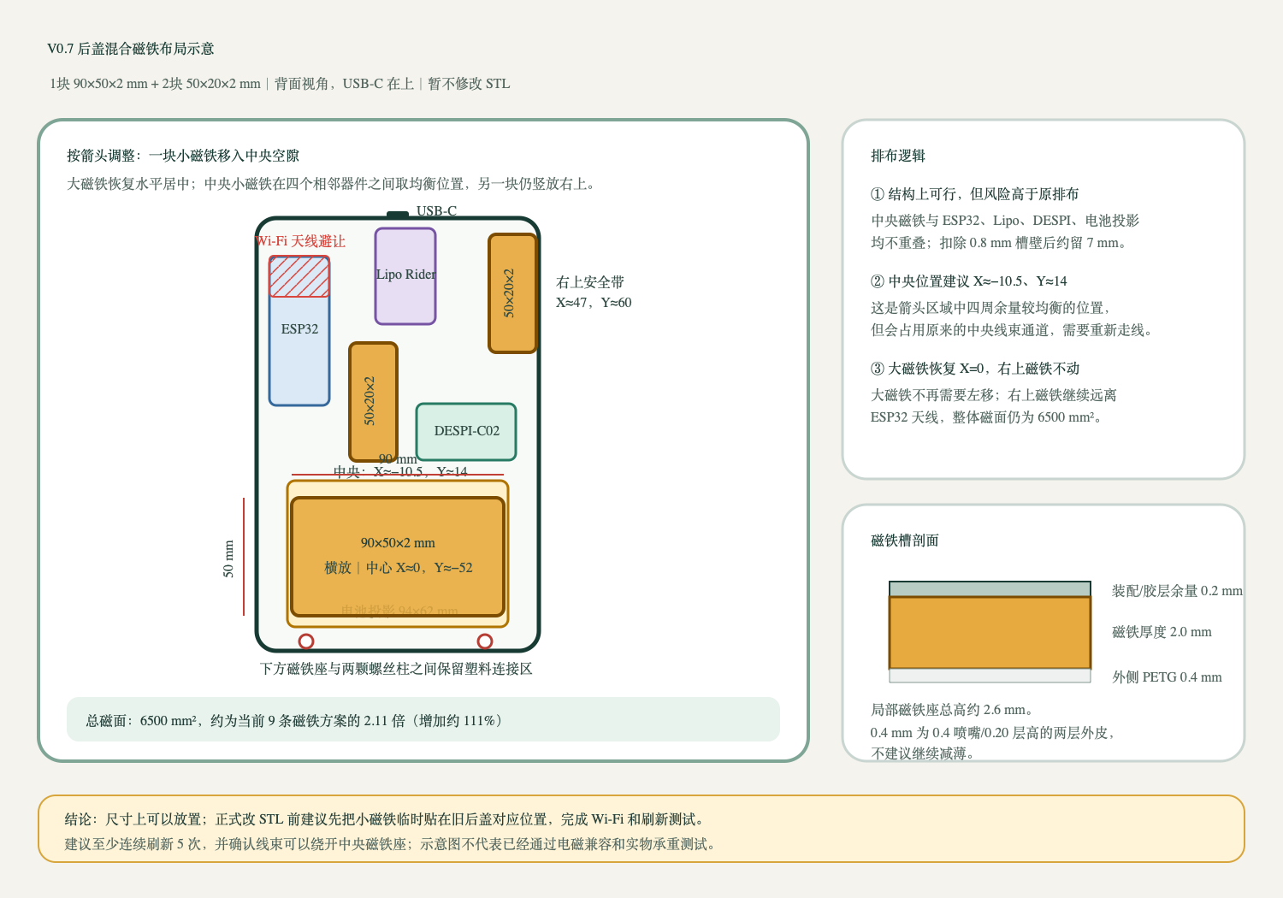
hardware/enclosure_v0_7/previews/magnet_layout_1x90x50_2x50x20_proposal_v0_7.png
