dinggefei/fridge-eink-display/hardware/enclosure_v0_7/previews/magnet_layout_90x50_50x20_proposal_v0_7.png

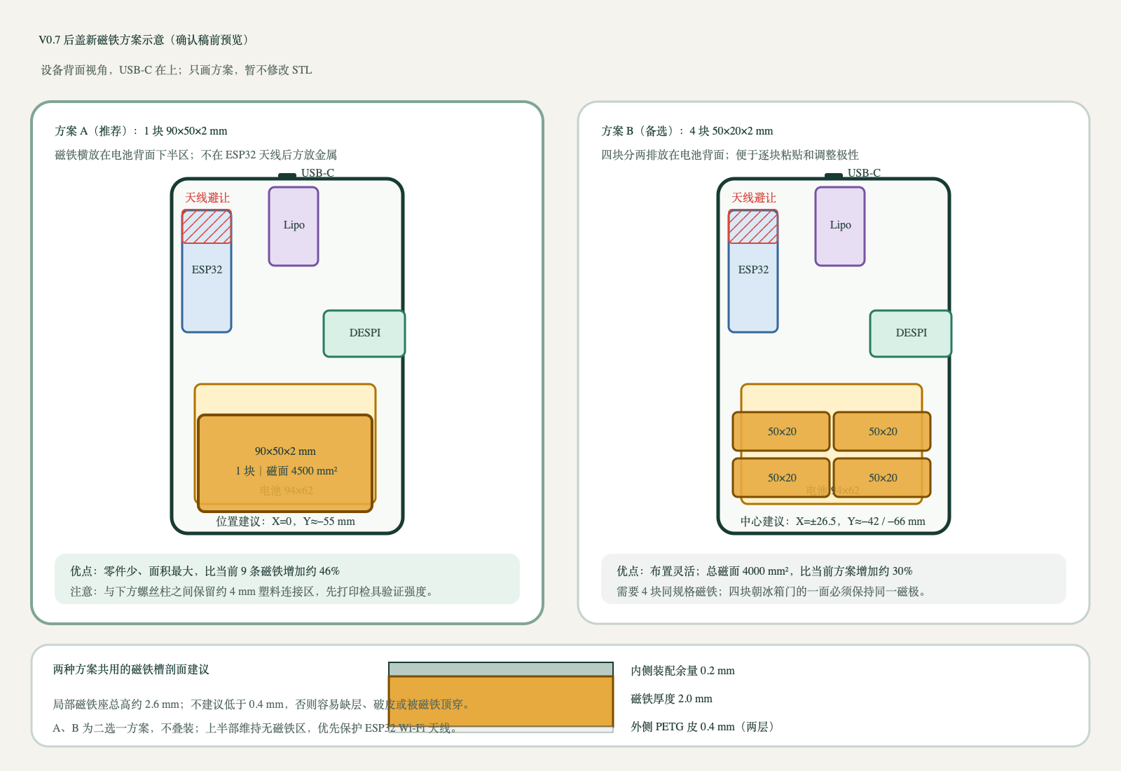
hardware/enclosure_v0_7/previews/magnet_layout_90x50_50x20_proposal_v0_7.png
