dinggefei/fridge-eink-display/hardware/enclosure_v0_7/previews/rear_coupon_hole_revision_v0_7_rev_b.png

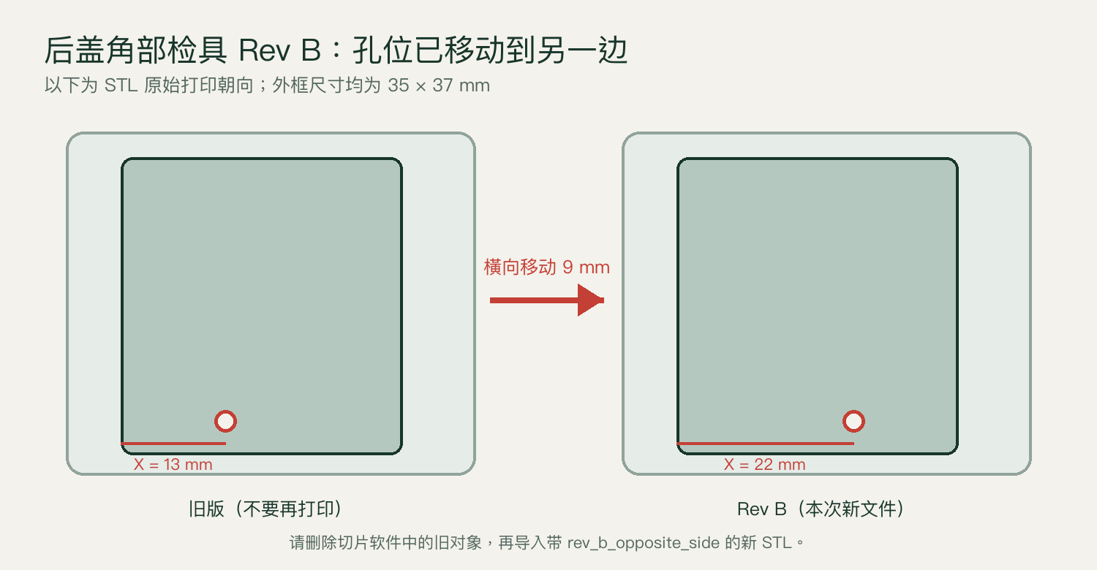
hardware/enclosure_v0_7/previews/rear_coupon_hole_revision_v0_7_rev_b.png
