dinggefei/fridge-eink-display/hardware/enclosure_v0_9_ultrathin/previews/layout_and_thickness_study_v0_9.png

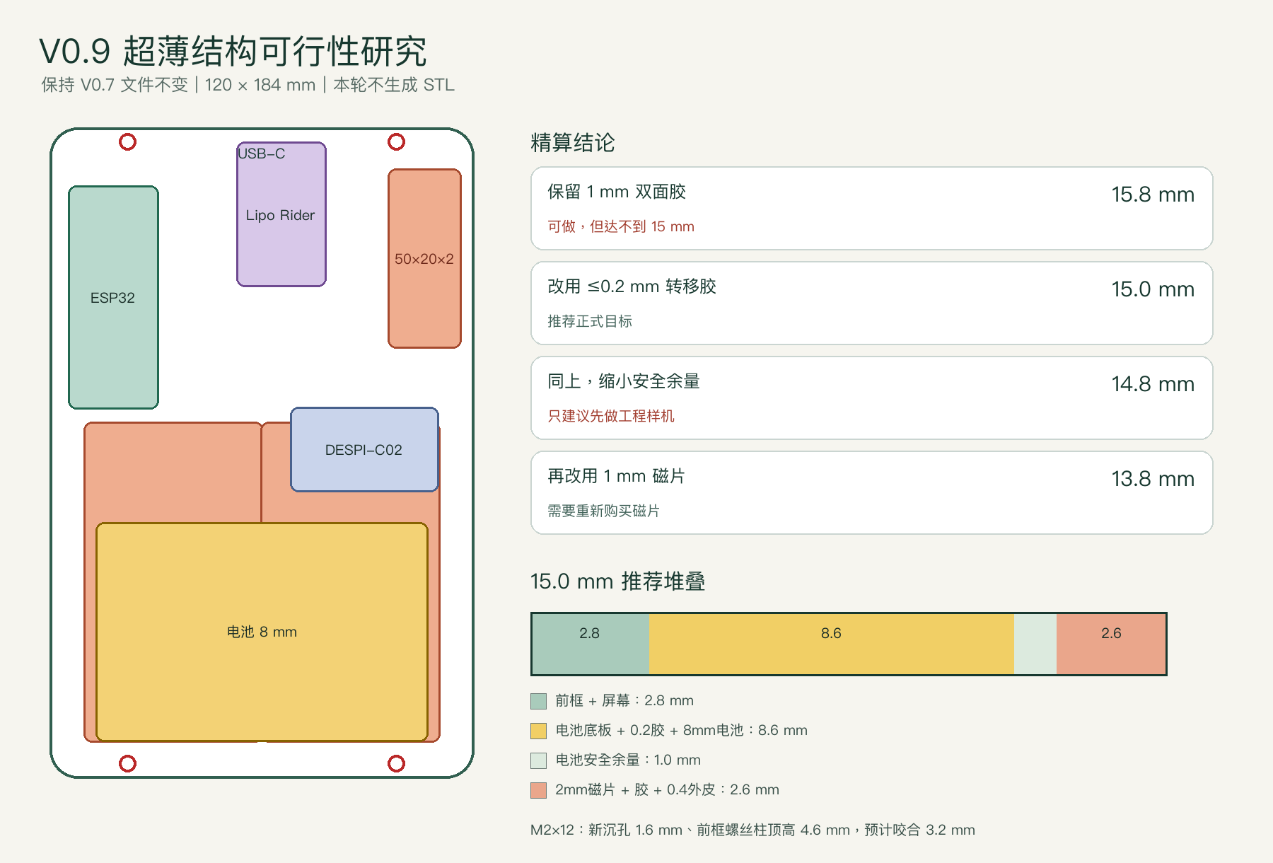
hardware/enclosure_v0_9_ultrathin/previews/layout_and_thickness_study_v0_9.png
