dinggefei/fridge-eink-display/docs/assets/current_inventory_preview.png

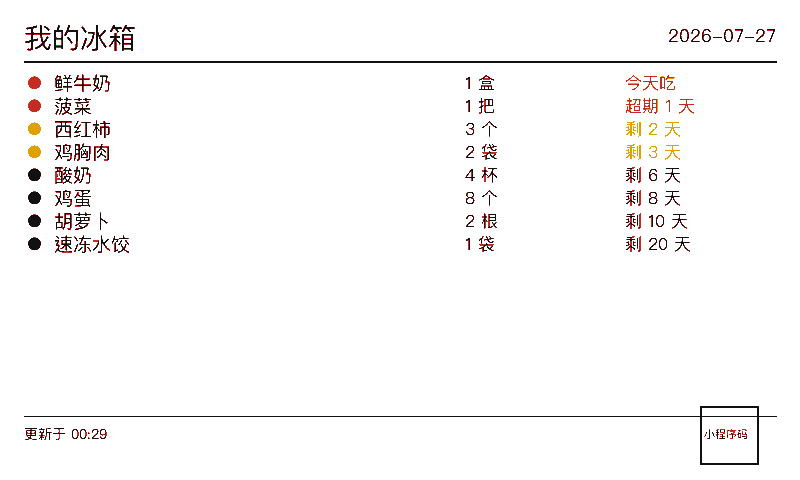
docs/assets/current_inventory_preview.png
