dinggefei/fridge-eink-display/hardware/enclosure_v0_7/output/fit_test_13_6mm_assembled_height_v0_7.stl

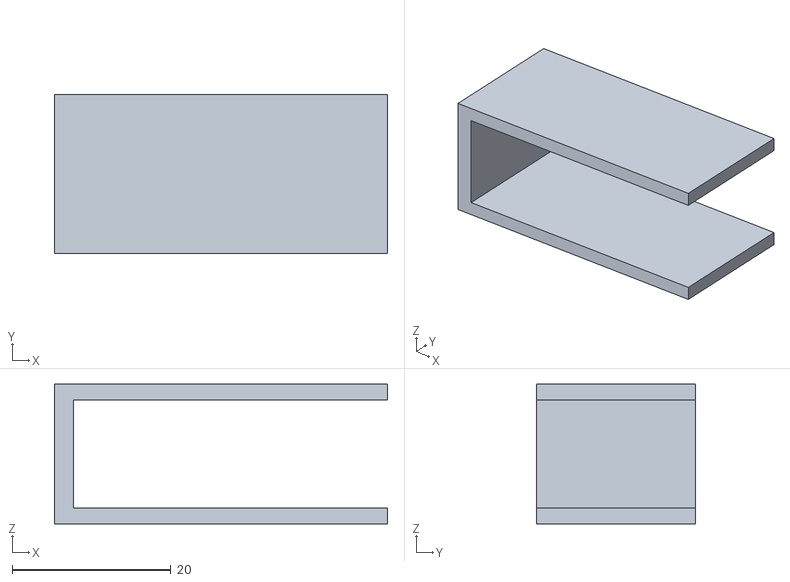
[picture p29: CAD file, 2026-10-11]
hardware/enclosure_v0_7/output/fit_test_13_6mm_assembled_height_v0_7.stl
42.0 x 20.0 x 17.6
