dinggefei/fridge-eink-display/hardware/enclosure_v0_7/output/fit_test_soft_magnet_2mm_skin_0p4_v0_7.stl

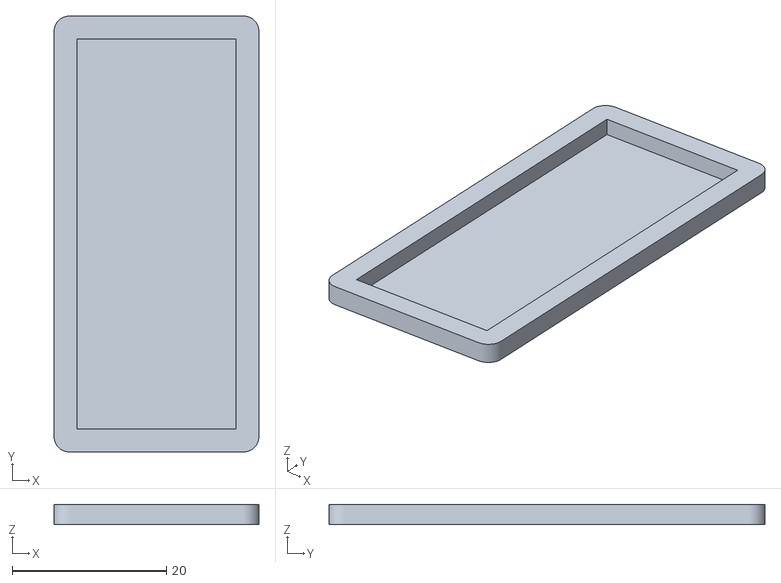
[picture p30: CAD file, 2026-10-11]
hardware/enclosure_v0_7/output/fit_test_soft_magnet_2mm_skin_0p4_v0_7.stl
26.6 x 56.6 x 2.60
