dinggefei/fridge-eink-display/hardware/enclosure_v0_9_ultrathin/output/rear_cover_v0_9_15p0mm.stl

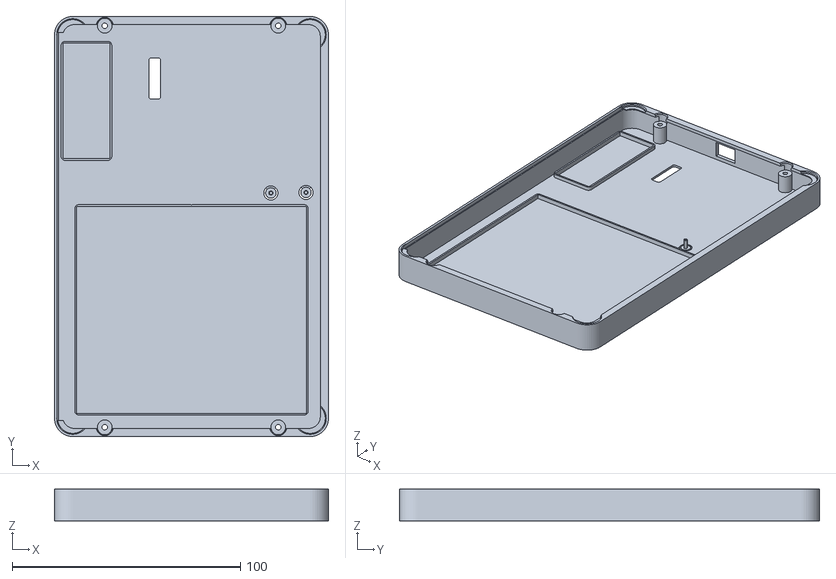
[picture p31: CAD file, 2026-10-11]
hardware/enclosure_v0_9_ultrathin/output/rear_cover_v0_9_15p0mm.stl
120.0 x 184.0 x 14.0
