dinggefei/fridge-eink-display/hardware/enclosure_v0_7/output/fit_test_lipo_combined_led_switch_opening_v0_7_rev_h.stl

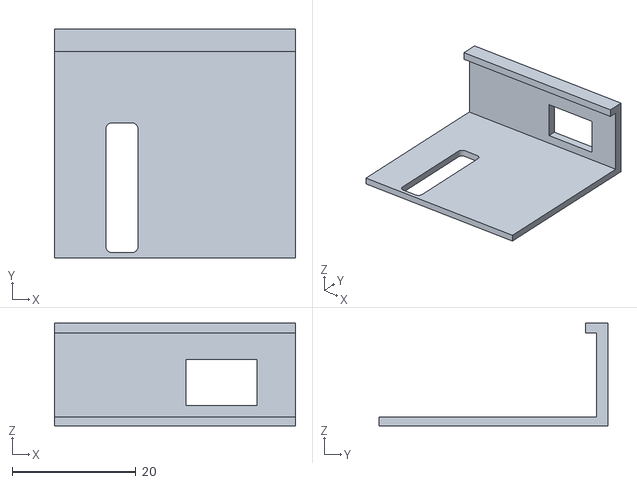
[picture p32: CAD file, 2026-10-11]
hardware/enclosure_v0_7/output/fit_test_lipo_combined_led_switch_opening_v0_7_rev_h.stl
39.0 x 37.0 x 16.6
