dinggefei/fridge-eink-display/hardware/enclosure_v0_9_ultrathin/output/fit_test_front_corner_v0_9_1p0mm.stl

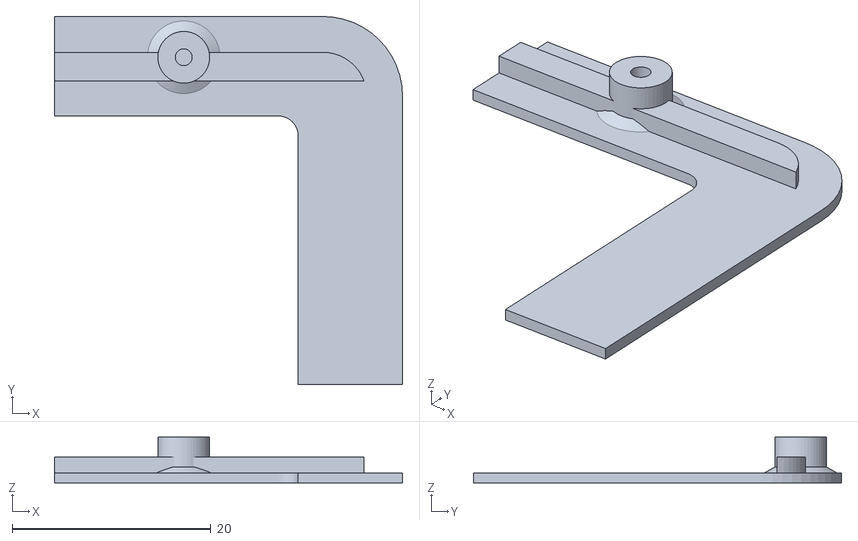
[picture p33: CAD file, 2026-10-11]
hardware/enclosure_v0_9_ultrathin/output/fit_test_front_corner_v0_9_1p0mm.stl
35.0 x 37.0 x 4.60
