dinggefei/fridge-eink-display/hardware/enclosure_v0_7/output/esp32_dupont_terminal_clamp_v0_7_rev_a.stl

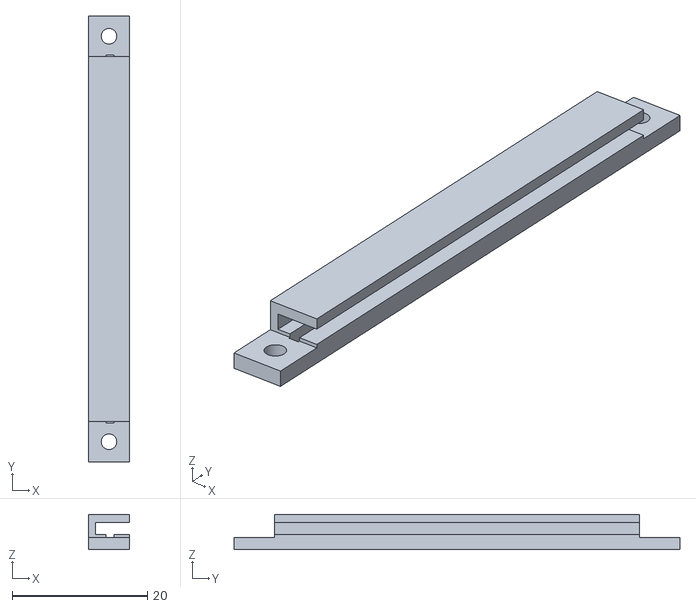
[picture p34: CAD file, 2026-10-11]
hardware/enclosure_v0_7/output/esp32_dupont_terminal_clamp_v0_7_rev_a.stl
6.00 x 66.0 x 5.20
