dinggefei/fridge-eink-display/hardware/enclosure_v0_9_ultrathin/output/electronics_carrier_v0_9_1p2mm.stl

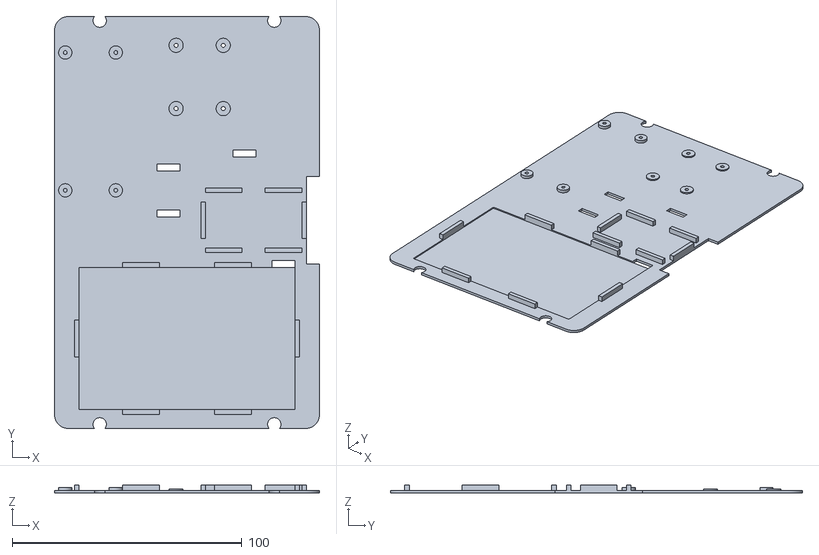
[picture p35: CAD file, 2026-10-11]
hardware/enclosure_v0_9_ultrathin/output/electronics_carrier_v0_9_1p2mm.stl
115.4 x 179.4 x 3.70
