dinggefei/fridge-eink-display/hardware/enclosure_v0_7/output/fit_test_front_left_retainer_v0_7_rev_e_square_inner.stl

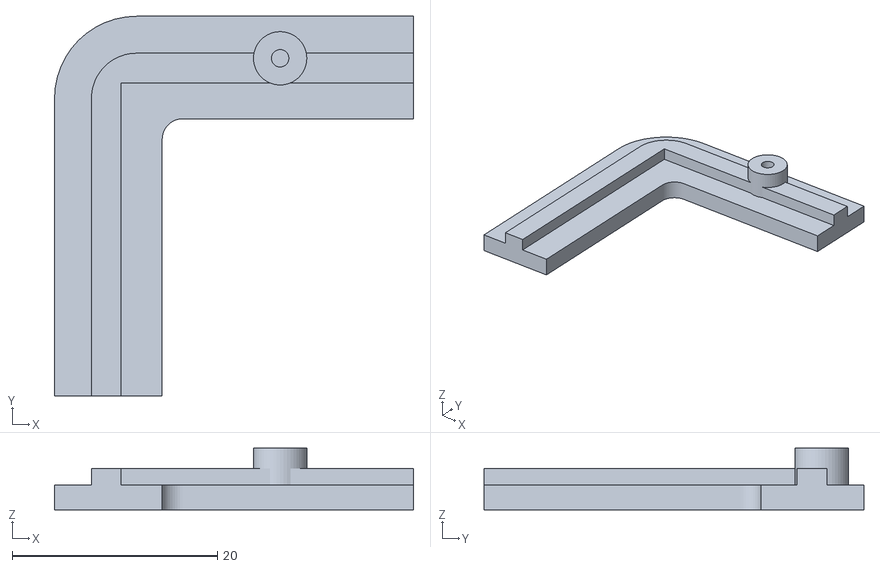
[picture p36: CAD file, 2026-10-11]
hardware/enclosure_v0_7/output/fit_test_front_left_retainer_v0_7_rev_e_square_inner.stl
35.0 x 37.0 x 6.00
