dinggefei/fridge-eink-display/hardware/enclosure_v0_9_ultrathin/output/fit_test_boot_reset_buttons_4p5mm_v0_9.stl

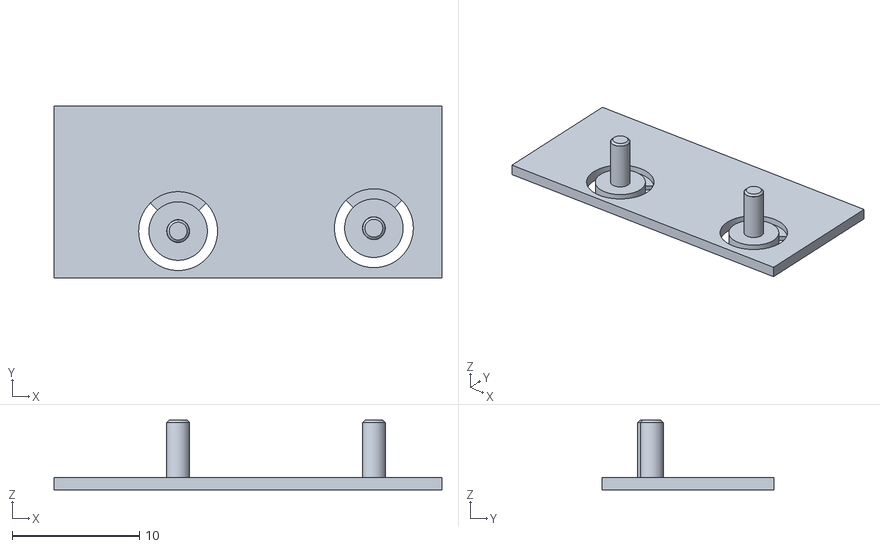
[picture p37: CAD file, 2026-10-11]
hardware/enclosure_v0_9_ultrathin/output/fit_test_boot_reset_buttons_4p5mm_v0_9.stl
30.5 x 13.5 x 5.50
