dinggefei/fridge-eink-display/hardware/enclosure_v0_7/output/fit_test_boot_reset_labels_v0_7.stl

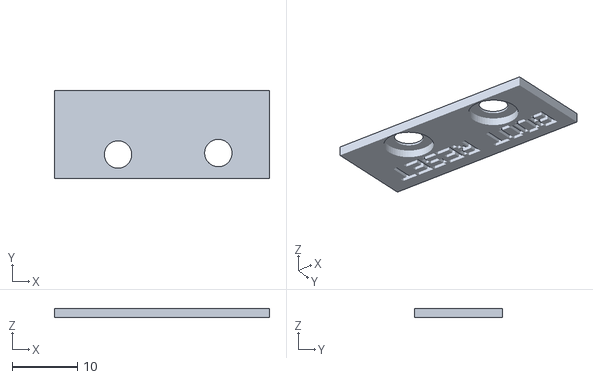
[picture p38: CAD file, 2026-10-11]
hardware/enclosure_v0_7/output/fit_test_boot_reset_labels_v0_7.stl
33.0 x 13.5 x 1.40
