dinggefei/fridge-eink-display/hardware/enclosure_v0_9_ultrathin/output/fit_test_lipo_indicator_opening_5p2x18_v0_9.stl

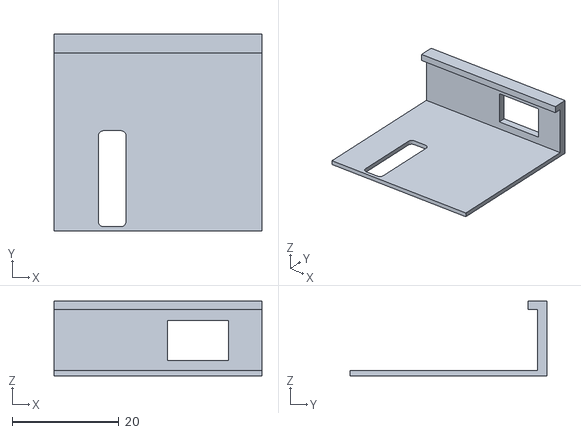
[picture p39: CAD file, 2026-10-11]
hardware/enclosure_v0_9_ultrathin/output/fit_test_lipo_indicator_opening_5p2x18_v0_9.stl
39.0 x 37.0 x 14.0
