dinggefei/fridge-eink-display/hardware/enclosure_v0_9_ultrathin/output/front_bezel_v0_9_1p0mm.stl

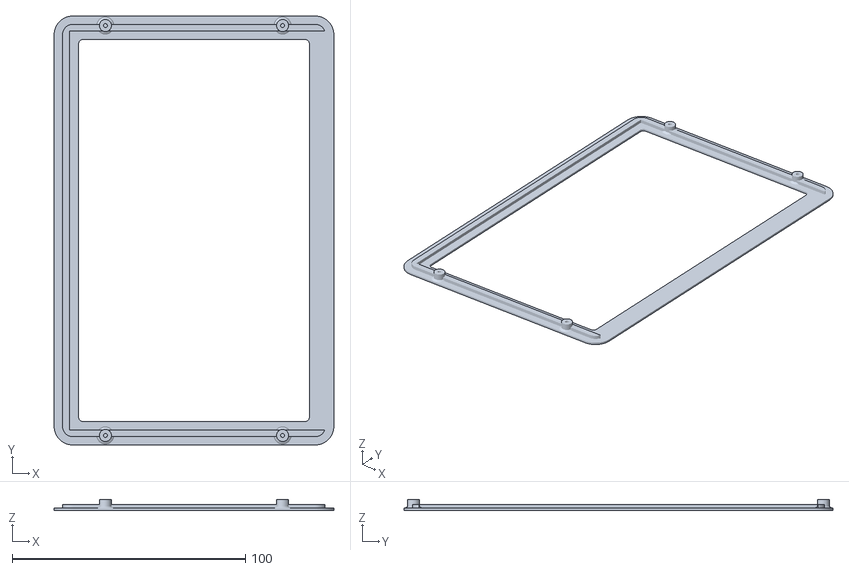
[picture p40: CAD file, 2026-10-11]
hardware/enclosure_v0_9_ultrathin/output/front_bezel_v0_9_1p0mm.stl
120.0 x 184.0 x 4.60
