dinggefei/fridge-eink-display/hardware/enclosure_v0_7/output/fit_test_rear_corner_v0_7_rev_b_opposite_side.stl

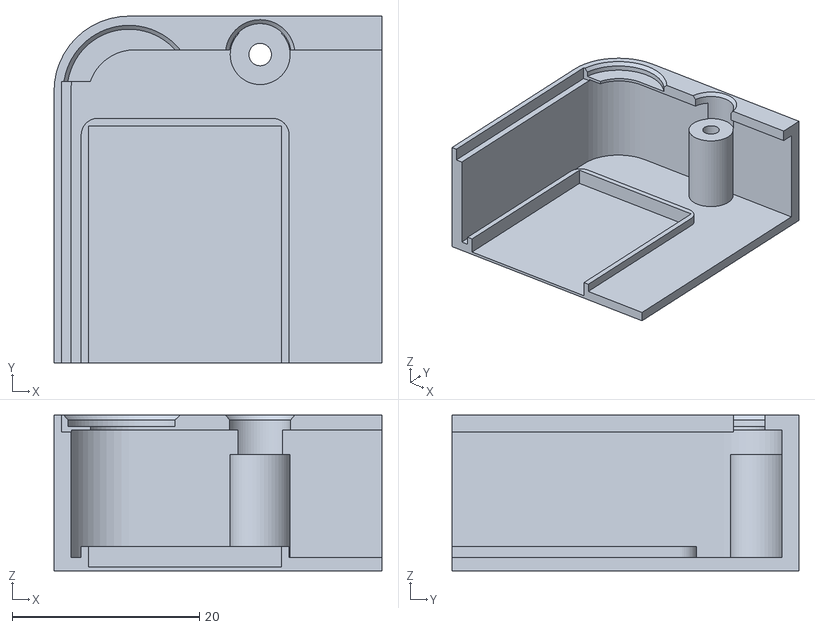
[picture p41: CAD file, 2026-10-11]
hardware/enclosure_v0_7/output/fit_test_rear_corner_v0_7_rev_b_opposite_side.stl
35.0 x 37.0 x 16.6
