dinggefei/fridge-eink-display/hardware/enclosure_v0_9_ultrathin/output/fit_test_usb_c_opening_11p5x7p5_v0_9.stl

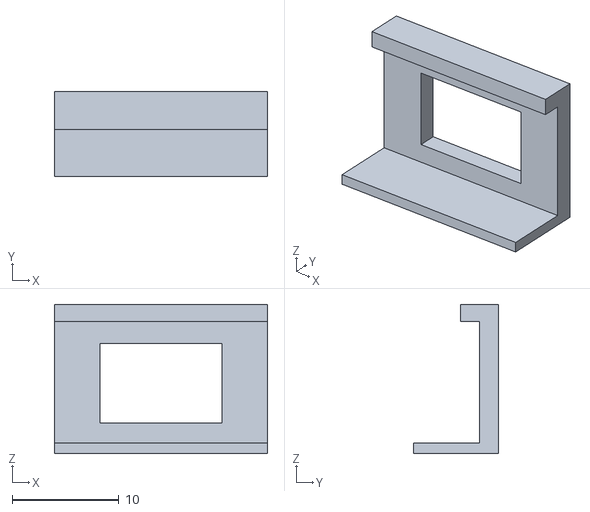
[picture p42: CAD file, 2026-10-11]
hardware/enclosure_v0_9_ultrathin/output/fit_test_usb_c_opening_11p5x7p5_v0_9.stl
20.0 x 8.00 x 14.0
