dinggefei/fridge-eink-display/hardware/enclosure_v0_7/output/fit_test_dupont_terminal_base_v0_7_rev_a.stl

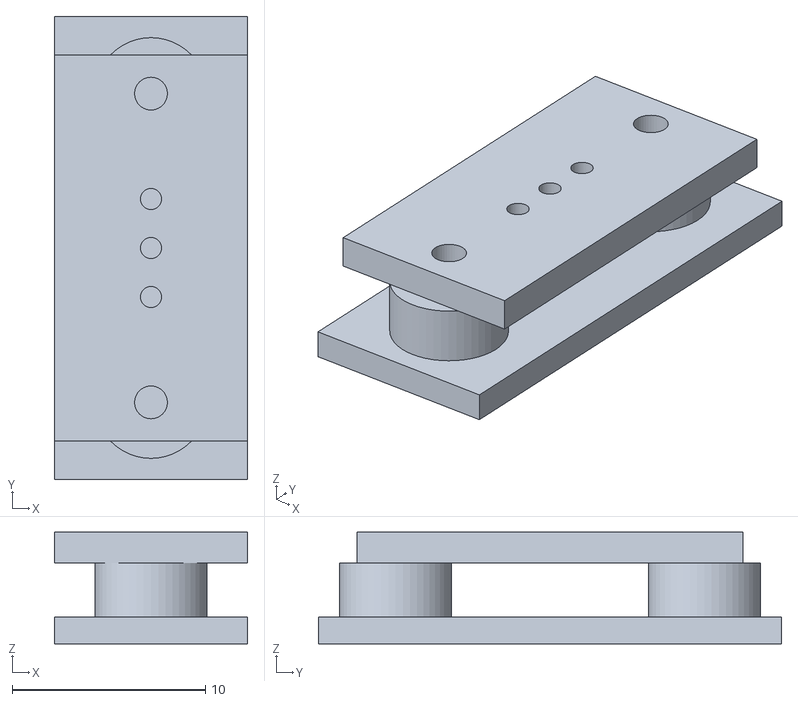
[picture p43: CAD file, 2026-10-11]
hardware/enclosure_v0_7/output/fit_test_dupont_terminal_base_v0_7_rev_a.stl
10.0 x 24.0 x 5.80
