dinggefei/fridge-eink-display/hardware/enclosure_v0_7/output/fit_test_usb_c_opening_11p5x7p5_v0_7.stl

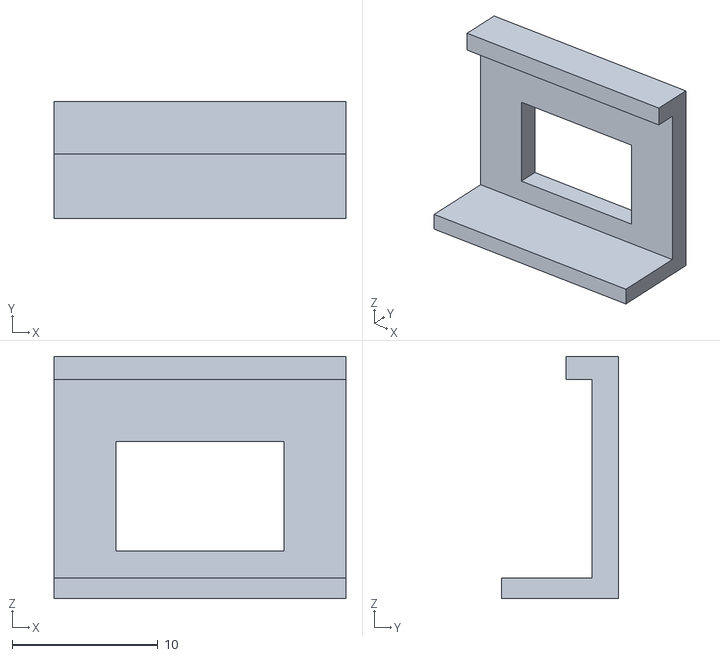
[picture p44: CAD file, 2026-10-11]
hardware/enclosure_v0_7/output/fit_test_usb_c_opening_11p5x7p5_v0_7.stl
20.0 x 8.00 x 16.6
