dinggefei/fridge-eink-display/hardware/enclosure_v0_7/output/fit_test_12_2mm_battery_magnet_zone_v0_7.stl

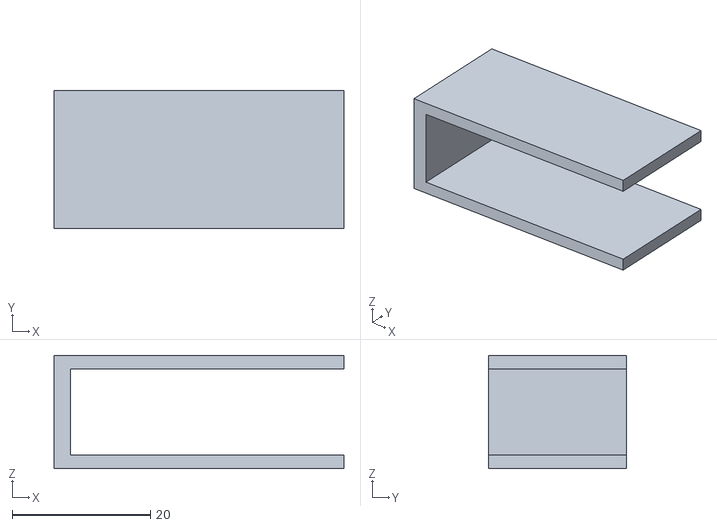
[picture p45: CAD file, 2026-10-11]
hardware/enclosure_v0_7/output/fit_test_12_2mm_battery_magnet_zone_v0_7.stl
42.0 x 20.0 x 16.4
