dinggefei/fridge-eink-display/hardware/enclosure_v0_7/output/fit_test_rear_left_flat_wall_0p8mm_v0_7_rev_f.stl

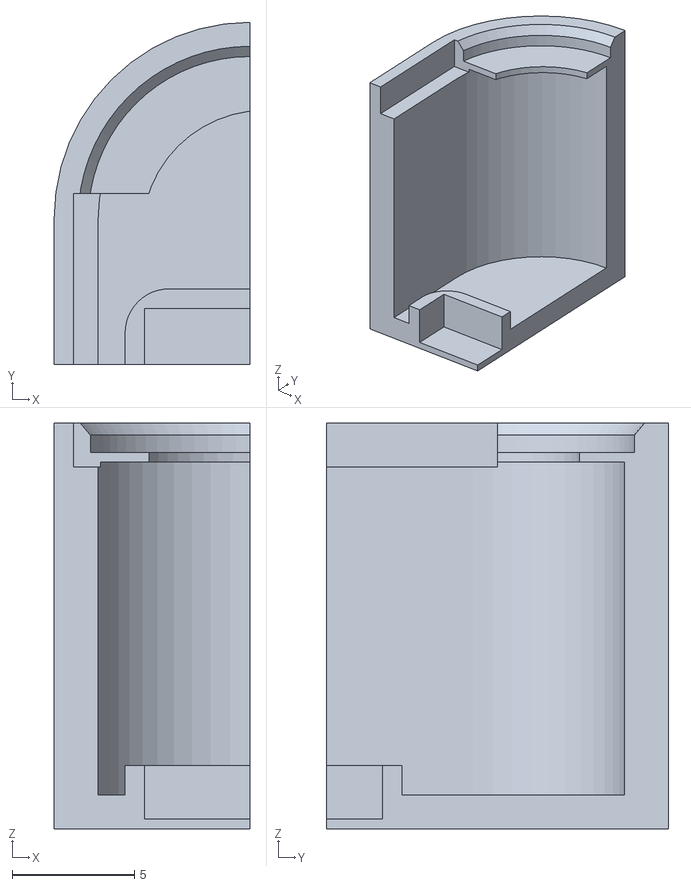
[picture p46: CAD file, 2026-10-11]
hardware/enclosure_v0_7/output/fit_test_rear_left_flat_wall_0p8mm_v0_7_rev_f.stl
8.00 x 14.0 x 16.6
