dinggefei/fridge-eink-display/hardware/enclosure_v0_7/output/fit_test_dupont_terminal_clamp_v0_7_rev_a.stl

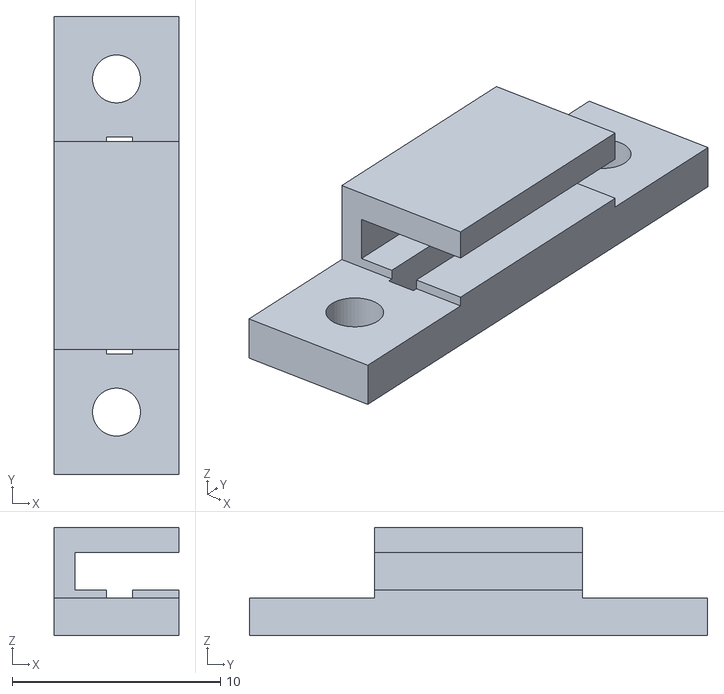
[picture p47: CAD file, 2026-10-11]
hardware/enclosure_v0_7/output/fit_test_dupont_terminal_clamp_v0_7_rev_a.stl
6.00 x 22.0 x 5.20
