dinggefei/fridge-eink-display/hardware/enclosure_v0_7/output/rear_cover_v0_7_rev_i_regular_lipo_led_switch_opening.stl

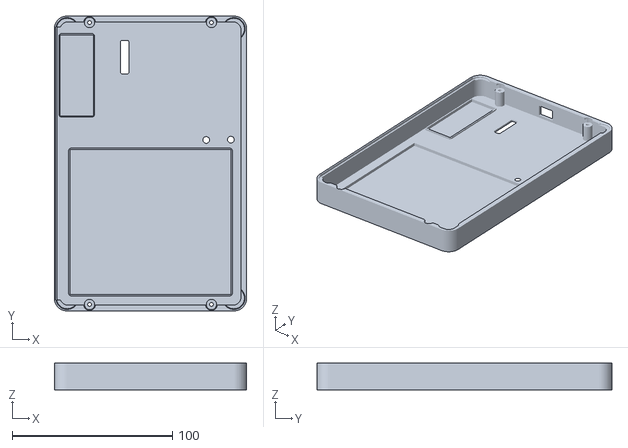
[picture p48: CAD file, 2026-10-11]
hardware/enclosure_v0_7/output/rear_cover_v0_7_rev_i_regular_lipo_led_switch_opening.stl
120.0 x 184.0 x 16.6
