dinggefei/fridge-eink-display/hardware/enclosure_v0_7/output/fit_test_carrier_corner_v0_7_rev_b_boss_relief_r2_9.stl

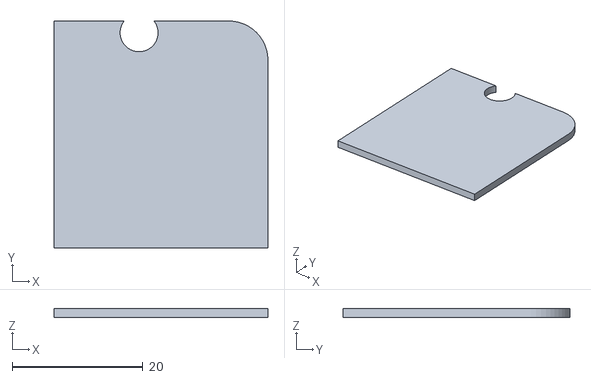
[picture p49: CAD file, 2026-10-11]
hardware/enclosure_v0_7/output/fit_test_carrier_corner_v0_7_rev_b_boss_relief_r2_9.stl
32.7 x 34.7 x 1.40
