dinggefei/fridge-eink-display/hardware/enclosure_v0_7/output/front_bezel_v0_7.stl

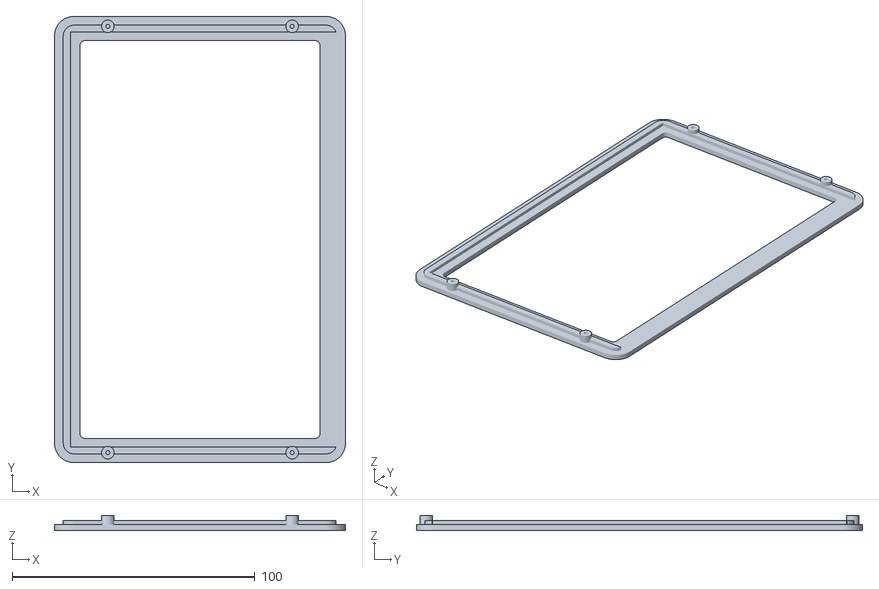
[picture p50: CAD file, 2026-10-11]
hardware/enclosure_v0_7/output/front_bezel_v0_7.stl
120.0 x 184.0 x 6.00
