dinggefei/fridge-eink-display/hardware/enclosure_v0_7/output/fit_test_front_corner_v0_7.stl

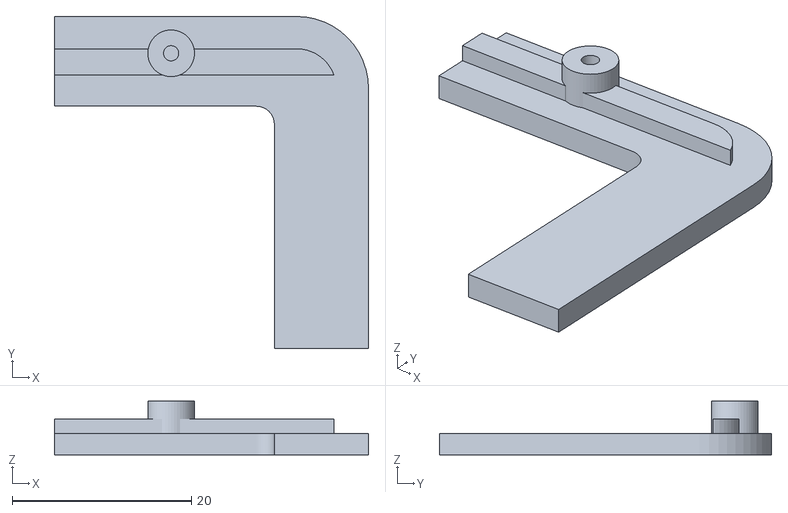
[picture p51: CAD file, 2026-10-11]
hardware/enclosure_v0_7/output/fit_test_front_corner_v0_7.stl
35.0 x 37.0 x 6.00
