dinggefei/fridge-eink-display/hardware/enclosure_v0_7/output/electronics_carrier_v0_7.stl

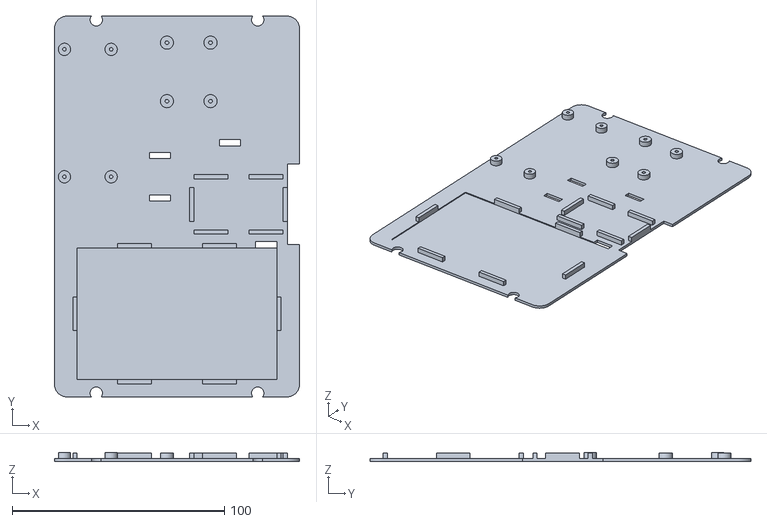
[picture p52: CAD file, 2026-10-11]
hardware/enclosure_v0_7/output/electronics_carrier_v0_7.stl
115.4 x 179.4 x 4.20
