dinggefei/fridge-eink-display/(list of files, cad)

Other CAD files:
hardware/enclosure_v0_1/output/fit_test_battery_thickness_9mm.stl
hardware/enclosure_v0_1/output/fit_test_m2_insert_and_magnet.stl
hardware/enclosure_v0_1/output/fit_test_screen_width_112mm.stl
hardware/enclosure_v0_1/output/front_bezel_v0_1.stl
hardware/enclosure_v0_1/output/middle_carrier_v0_1.stl
hardware/enclosure_v0_1/output/rear_cover_v0_1.stl
hardware/enclosure_v0_2/output/middle_carrier_v0_2.stl
hardware/enclosure_v0_3/output/fit_test_lipo_top_port_v0_3.stl
hardware/enclosure_v0_3/output/middle_carrier_v0_3.stl
hardware/enclosure_v0_3/output/rear_cover_v0_3.stl
hardware/enclosure_v0_4/output/fit_test_button_hole_diameter_v0_4.stl
hardware/enclosure_v0_4/output/middle_carrier_v0_4.stl
hardware/enclosure_v0_4/output/rear_cover_v0_4.stl
hardware/enclosure_v0_5/output/fit_test_carrier_corner_v0_5.stl
hardware/enclosure_v0_5/output/fit_test_esp32_four_hole_mount_v0_5.stl
hardware/enclosure_v0_5/output/fit_test_rear_corner_v0_5.stl
hardware/enclosure_v0_5/output/middle_carrier_v0_5.stl
hardware/enclosure_v0_5/output/rear_cover_v0_5.stl
hardware/enclosure_v0_6/output/electronics_carrier_v0_6.stl
hardware/enclosure_v0_6/output/fit_test_13_4mm_assembled_height_v0_6.stl
hardware/enclosure_v0_6/output/fit_test_carrier_corner_v0_6.stl
hardware/enclosure_v0_6/output/fit_test_front_corner_v0_6.stl
hardware/enclosure_v0_6/output/fit_test_rear_corner_v0_6.stl
hardware/enclosure_v0_6/output/front_bezel_v0_6.stl
hardware/enclosure_v0_6/output/rear_cover_v0_6.stl
