dinggefei/fridge-eink-display/hardware/enclosure_v0_1/PRINT_ORDER.md

# V0.1 线上打印下单说明

## 第一单：只打印试配件

上传 `RFM_enclosure_v0_1_test_fit_STL.zip` 中的三个 STL，每件数量 1：

- `fit_test_screen_width_112mm.stl`
- `fit_test_battery_thickness_9mm.stl`
- `fit_test_m2_insert_and_magnet.stl`

下单参数：FDM、白色 PETG、0.20 mm 层高、4 道墙、20% 填充、不缩放、单位 mm。若商家不接受压缩包，分别上传三个 STL。

收到后必须完成以下验收：

- 屏幕可自然放入 112 mm 检具，不夹紧，也没有明显左右晃动。
- 电池可轻松进入 9 mm 槽；若电池厚度超过 9 mm，记录实测厚度，不得强塞。
- M2 热熔螺母能稳定装入 3.2 mm 孔，M2 螺丝能通过 2.4 mm 孔。
- 10 × 3 mm 磁铁能放入 10.4 × 3.2 mm 孔，胶水固化前仍可取出。

## 第二单：试配通过后打印主外壳

上传 `RFM_enclosure_v0_1_main_STL.zip` 中的三个 STL，每件数量 1：

- `front_bezel_v0_1.stl`
- `middle_carrier_v0_1.stl`
- `rear_cover_v0_1.stl`

建议参数：FDM、白色或浅灰色 PETG、0.20 mm 层高、4 道墙、顶底各 5 层、20%～25% Gyroid 填充、不缩放、单位 mm。

最大零件平面尺寸为 128 × 200 mm，商家的成型范围必须覆盖 200 mm。

## 发给商家的备注

可以直接复制以下内容：

> 文件单位为毫米，请保持 100% 比例，禁止自动缩放。材料使用 PETG，0.20 mm 层高，4 道墙，20%～25% Gyroid 填充。正面边框外观面朝下，中层托板平面朝下，后盖外表面朝下。不要擅自封闭或缩小 2.4 mm 螺丝通孔、3.2 mm 热熔螺母孔以及 10.4 × 3.2 mm 磁铁盲孔。如切片认为底部接口需要支撑，请只加局部支撑并先确认。

## 暂停付款的条件

商家若出现以下任一情况，先不要付款：

- 系统显示的模型尺寸不是 128 × 200 mm 量级。
- 系统提示模型需要自动修复，且修复后孔位消失。
- PETG 不可选，却自动替换为光敏树脂或尼龙。
- 商家要求对完整模型做等比例缩放才能打印。
- 三件主外壳没有被识别为三个独立零件。
