dinggefei/fridge-eink-display/hardware/enclosure_v0_7/previews/assembly_effect_v0_7.png

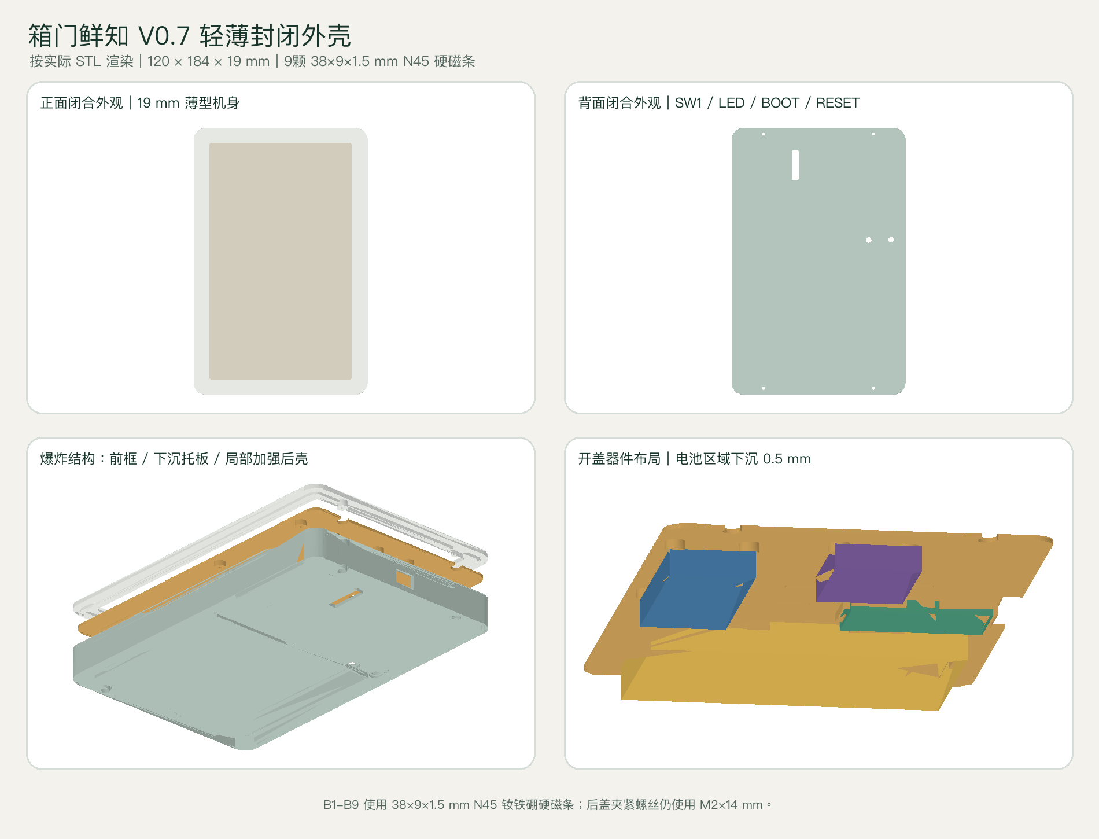
hardware/enclosure_v0_7/previews/assembly_effect_v0_7.png
