dinggefei/fridge-eink-display/hardware/enclosure_v0_7/previews/corner_fit_assembly_v0_7.png

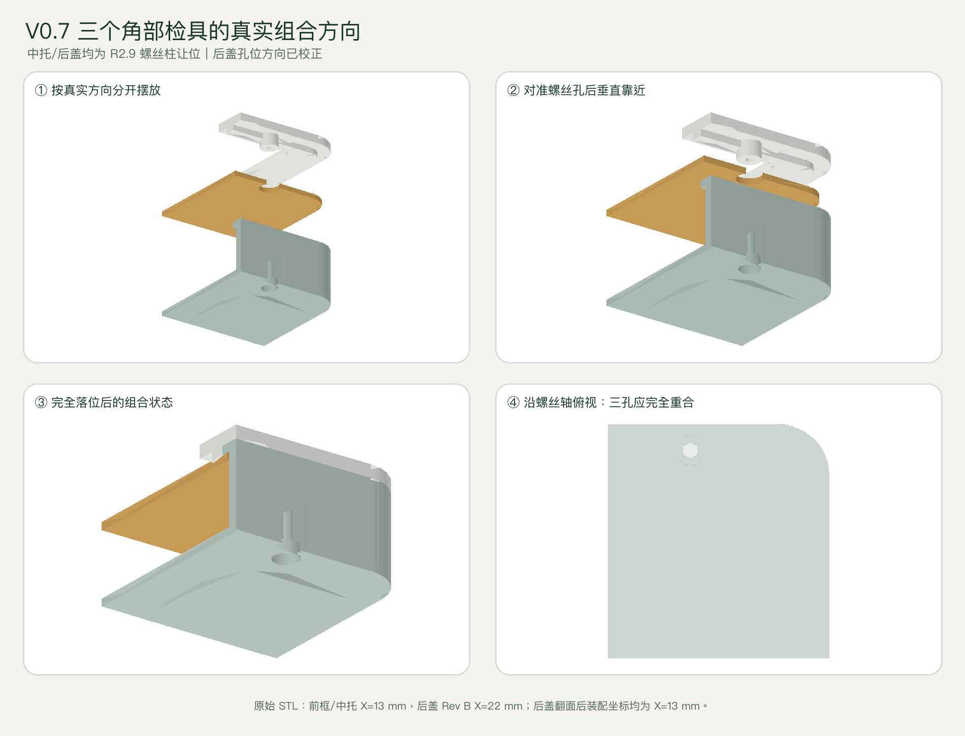
hardware/enclosure_v0_7/previews/corner_fit_assembly_v0_7.png
