dinggefei/fridge-eink-display/firmware/bringup/wifi_scan/README.md

# ESP32-S3 Wi-Fi 扫描自检

该程序在不需要密码的情况下扫描附近的 2.4 GHz Wi-Fi，验证 ESP32-S3
无线功能、天线摆放和串口输出。

成功条件：

- 至少扫描到一个网络；
- 串口输出 `RESULT: PASS`。

程序会在本地串口显示 SSID。分享截图前请遮挡不希望公开的网络名称和 MAC
地址。扫描结束后程序会关闭 Wi-Fi，不会修改墨水屏画面。
